armstrong0/PDP8e/README

Autostart is now implemented.  If the sw switch is asserted and then the unit is powered up, the boot code for OS8 is deposited into memory and executed.  Note there is a small delay while the code waits for the sd card to be ready. 

Now booting OS8 from SD Card!!

Timing information removed from parameters.v and now in timing.v   A module in the same directory as the top level (for the particular FPGA) generates timing debounce constants for the serial port and the spi port of the sd card interface.  As well it generates start up delays for the sd card and the delays for the front panel.

This PDP8e (ice40hx8k) can now have 10 k words of memory.  The only caviot is that to pass Adder and Extended Memory diagnostics you must recompile to 8 k.

There has been a major state machine revision where most of the exceptional processing is handle in F0 istead of various states (F3, E3, D3, H0).  Easier to make sure I have all of the conditions covered.

All tests now pass.  The ma and pc units have been merged.  All source files have been linted and formatted.  Lint does not like the bit ordering in the PDP8's registers but I kept it. 

The design passes all three EAE tests, so a complete EAE implementation.  

//There is a problem with the serial port, if the halt switch is set, it is 
//possible that the serial transmitter was in the middle of a character, 
//leaving the line is the spacing state, this messes up the receiving uart.
This is NOT a problem!  Halt does not stop the TX state machine from running.  Iwill complete the sending of the charactor.  The main state machine will stop in the F0 state and nothing more will happen!

The front panel code has been modified so that: when in halt state and a control switch is toggled the run LED comes on for the debounce time.  

The Least Significant Bit (bit 11) of the state display has been reallocated to the EAE state, LED on signifies the "B" mode.

Bit 9 of the state display indicates if the disk (sd card) is ready.

Toggling the "sw" switch up and pressing address load result in octal 7777 being loaded into the memory address register, useful when starting the binary loader - which is loaded in memory during FPGA boot.  It is necessary to have switch 0 up (high) for the bootloader to use the console port.

The top level Makefile can be used to clean the subdirectories. Some of the sub directory makefiles have been modified to allow a target of vdent.  This formats the code in that subdirectory.

Hardware is an ICE40HX8K device on an ICEWERKS module bought from robot shop.

Front panel has a self designed graphic... Code to design it is in another
repository.  Also in that repository is a set of tools to determine the wiring
required.  Wiring was mostly done with 30 AWG wirewrap wire.  Switches however
were wired with 22 AWG copper bus wire.  

Almost all of the circuitry is on the Icewerks modules.  Exceptions are the
LED's and associated current limiting resistors, toggle switches, rotary
display select switch and a USB to TTL serial module.  Two 33 ufd caps were,
placed between 3.3 volt and ground on the switch buses.  3 30 AWG wires were
used to connect the ICEWERKS module ground to the switch ground.  Only 1 30
AWG wire is used to hook up 3.3 Volts.

Yellow LED's required - address 15, data display 12, run 1 and display selected
indicator 6.  Total 34.  Current limit resistor value is: 220 ohms.

The rotary switch has been replaced with a push button switch.  When the rotary switch was used, all of the 6 lines assigned to this function were inputs to the FPGA and the LEDS were driven from the switch. Now one input is used by the push button switch.  The other 5 lines are now outputs driving the LEDS.  LED's are grouped into two groups three.  The cathodes of the three LEDS are tied together and through a 220 ohm resistor go to an FPGA pin.  Same for the other group of three.  Then corresponding anodes of LED's are tied together and are driven by an FPGA pin.  To turn a LED on the cathode of the LED is driven low, either (01 or 10) and the anode is driven high (100, 010, or 001).   

This repository contains the Verilog code for the FPGA and test code to verify
code correctness.  

The design is partitioned into pieces, each piece has its own directory.  In
some directories test code exists to test that module.  

The tools required to build this code are a verilog compiler, a verilog
simulator, a couple of PDP8 tools palbart and macro8x.  The palbart version
required is: pal-2.13, 03 May 2015.

The FPGA tools used are Icestorm tools set, yosys and nextnpr.  Iverilog was
used as a simulator and Verilator was used as a linting tool.

The directory "integrate" contains a test bed that will run selected DEC PDP8e
diagnostics, this was used to debug and verify the design.  This directory also contains a script that leads one though loading a diagnostic program onto hardware and then running the test.

The FPGA that was targeted is a Lattice Semiconductor ICE40Hx8k.  Very little
code is targeted at that FPGA, that is the code that sets up the internal pll
: pll.v the remaining (and vast majority ) code is generic.  A hardware wait state has been added so that memory reads take 2 states, I think this is necessary because the 8k x 12 memory is made of 4 kilobit block ram.  This necessitates lots of levels of logic after the memories in order to select the correct memory.  

The directory FPGA_IO_test contains code useful in testing out wiring.
Entering the directory and typing make should build an FPGA image that can be
burned into the ICEWERKS module using the command "make burn".

To build the FPGA, enter the directory FPGA_image and type make.  If make is
successful, then the image can be burned into the flash device on the ICEWERKS
module using: make burn.
