armstrong0/PDP8e/ma/ma.v

`ifdef up5k
`include "../spram/up_spram.v"
`else
`include "../ram/ram.v"
`endif

module ma (
    input clk,
    input reset,
    input [0:11] ac,
    input [0:11] mq,
    input [0:11] sr,
    input sw,
    input [4:0] state,
    input addr_loadd,
    depd,
    examd,
    extd_addrd,
    input int_in_prog,
    input [0:2] IF,
    DF,
    input skip,
    input eskip,
`ifdef RK8E
    input [0:14] dmaAddr,
    input [0:11] disk2mem,
    input to_disk,
    input data_break,
    output reg [0:11] mem2disk,
`endif
    output reg index,
    output reg [0:11] instruction,
    output reg [0:11] mdout,
    output reg [0:14] eaddr  // drives the panel LEDs
);

  reg [0:4] current_page;
  reg [0:11] mdin, idx_tmp, pc, next_pc, skip_pc;
  reg write_en;
  wire [0:11] mdtmp;
  `include "../parameters.v"


`ifdef up5k
  up_spram ram (
      .wdata({4'b0, mdin}),
      .addr(eaddr),
      .wr(write_en),
      .clk(clk),
      .rdata(mdtmp)
  );
`else
  ram ram (
      .din(mdin),
      .addr(eaddr),
      .write_en(write_en),
      .clk(clk),
      .dout(mdtmp)
  );
`endif




  always @(posedge clk) begin
    if (reset) begin
      eaddr <= 15'o00000;
      instruction <= 12'o7000;
      current_page <= 0;
      write_en <= 0;
      index <= 1'b0;
`ifdef RK8E      
      mem2disk <= 12'o0;
`endif     
      idx_tmp <= 12'o0;
      mdin <= 12'o0;
    end else begin
      write_en <= 0;
      eaddr[3:14] <= eaddr[3:14];
      mdin <= mdin;
      case (state)
        F0: begin
          pc <= eaddr[3:14];
`ifdef RK8E	  
	  if (data_break == 1) begin
		  mdin <= disk2mem;
          eaddr <= dmaAddr;
          pc <= eaddr[3:14];
          end
`else          
          pc <= eaddr[3:14];
`endif
          mdout <= mdtmp;  // catches the case where we are spinning in F0
        end
        FW: begin
          mdout <= mdtmp;
          instruction <= mdtmp;
          eaddr[3:14] <= pc + 12'o0001;  // set up for fetch of immediate
          // operand or address for EAE operations
        end
        F1: ;
        F2: begin
          current_page <= pc[0:4];
          mdout <= mdtmp;
          skip_pc <= pc + 12'o0002;
          next_pc <= pc + 12'o0001;

        end
`ifdef EAE        
        F2A: begin
          casez (instruction)
            12'b1111??0?0011,  // 7403 SCL
            12'b1111??0?0101,  // 7405 MUY
            12'b1111??0?0111,  // 7407 DIV
            12'b1111??0?1011,  // 7413 SHL
            12'b1111??0?1101,  // 7415 ASR
            12'b1111??0?1111,  // 7417 LSR
            12'b1111??1?0101,  // SCA - MUL
            12'b1111??1?0111,  // SCA - DIV
            12'b1111?1111011,  // SCA - SHL
            12'b1111?1111101,  // SCA - ASR
            12'b1111??1?1111,  // SCA - LSR
            12'b1111??1?0011:  // SCA - SCL
            next_pc <= pc + 12'o2;  // skip the operand
            default next_pc <= pc + 12'o1;
          endcase
          mdout <= mdtmp;
        end
        F2B: begin
          casez (instruction)
            12'b1111??0?1011,  // 7413 SHL
            12'b1111??0?1101,  // 7415 ASR
            12'b1111??0?1111,  // 7417 LSR
            12'b1111??0?0101,  // 7405 MUY
            12'b1111??0?0111,  // 7407 DIV
            12'b1111??1?0011,  // DAD - DLD 7443 CAMDAD
            12'b1111??1?0101:  // DST 7445
          begin
              // eaddr has the address of the operand,
              // the memory cycle will be finished by the defer cycle
              next_pc <= pc + 12'o2;  // skip the operand
            end
            default: begin
              next_pc <= pc + 12'o1;
              skip_pc <= pc + 12'o2;
            end
          endcase
          mdout <= mdtmp;
        end
`endif        
        F3: begin
          casez (instruction[0:4])
            5'b0???0: eaddr <= {IF, 5'b0, instruction[5:11]};
            5'b0???1: eaddr <= {IF, current_page, instruction[5:11]};
            5'b100?0:  // JMS page 0
            eaddr <= {IF, 5'b0, instruction[5:11]};
            5'b100?1:  // JMS current page
            eaddr <= {IF, current_page, instruction[5:11]};
            5'b101?0: // JMP page 0
            begin
              eaddr   <= {IF, 5'b0, instruction[5:11]};
              next_pc <= {5'b0, instruction[5:11]};
            end
            5'b101?1: // JMP current page
            begin
              eaddr   <= {IF, current_page, instruction[5:11]};
              next_pc <= {current_page, instruction[5:11]};
            end
            5'b11???:  // 6 and 7 OPR and IOT
            if ((skip == 1) || (eskip == 1)) begin
              eaddr   <= {IF, skip_pc};
              next_pc <= skip_pc;
            end else eaddr <= {IF, next_pc};
          endcase
        end
        D0: if (eaddr[3:11] == 9'o001) index <= 1'b1;
 else index <= 1'b0;
        DW: begin
          mdout <= mdtmp;
        end
        D1: begin
          if (index == 1'b1) begin
            mdin <= mdout + 12'o0001;
            idx_tmp <= mdout + 12'o0001;
            write_en <= 1;
          end else eaddr[3:14] <= mdout;
        end
        D2: ;
        D3: begin
          if (index == 0) eaddr[3:14] <= mdout;
          else begin
            eaddr[3:14] <= idx_tmp;
            index <= 0;
          end
          ;
          casez (instruction[0:2])
            AND, TAD, ISZ, DCA, OPR: eaddr[0:2] <= DF;
            JMP: begin
              if (index) next_pc <= idx_tmp;  // both use IF which is set in F0
              else next_pc <= mdout;  // right address, ready for 
              // interrupt processing
              eaddr[0:2] <= IF;
            end

            JMS: ;
            IOT: ;  // should never get here
            default: ;
          endcase
        end
        E0: begin
`ifdef EAE        
          if ((instruction & 12'b111100101111) == DST) begin
            mdin <= mq;
            write_en <= 1'b1;
          end
`endif          
        end
        EW: begin
          if (int_in_prog == 1) begin
            instruction <= 12'o4000;
            eaddr <= 15'o0000;
            mdin <= next_pc;
          end else
            case (instruction[0:2])
              ISZ, AND, TAD: ;
              JMS: begin
                   mdin <= next_pc;
                   eaddr[0:2] <= IF; // handles JMS across fields
                   end
              DCA: mdin <= ac;
              OPR: begin
                eaddr[3:14] <= eaddr[3:14] + 12'd1;
                mdin <= ac;
                mdout <= mdtmp;
              end
              default: ;
            endcase
          mdout <= mdtmp;
        end
        E1:
        case (instruction[0:2])
          ISZ: begin
            mdin <= mdout + 12'o0001;
            write_en <= 1;
            if (mdout == 12'o7777) next_pc <= skip_pc;
          end
          JMS: begin
            write_en <= 1;
            mdin <= next_pc;
          end
          DCA: begin
            mdin <= ac;
            write_en <= 1;
          end
          OPR: begin
`ifdef EAE          
            if ((instruction & 12'b111100101111) == DST) begin
              mdin <= ac;
              write_en <= 1'b1;
            end
`endif            
          end
          default: ;
        endcase
        E2: begin
          case (instruction[0:2])
            ISZ: ;
            DCA: mdin <= ac;
            JMS:
            if (int_in_prog) begin
              eaddr   <= 15'o0001;
              next_pc <= 12'o0001;
            end else next_pc <= eaddr[3:14] + 12'd1;
            OPR: ;
          endcase
          mdout <= mdtmp;
        end
        E3: begin
          // on interrupt we go to IF 0 set up in E2 above
          if (int_in_prog == 1) eaddr <= {3'b000, next_pc};
          else eaddr <= {IF, next_pc};
        end
        //H0: ;
        HW: mdout <= mdtmp;
        H1:
        if (addr_loadd == 1'b1)
          if (sw == 1'b1) eaddr[3:14] <= 12'o7777;
          else eaddr[3:14] <= sr;
        else if (depd == 1'b1) begin
          mdin <= sr;
          write_en <= 1;
        end 
        else if (extd_addrd == 1'b1) begin
          eaddr[0:2] <= sr[6:8];
        end  
        H2: if ((depd == 1'b1) | (examd == 1'b1)) eaddr[3:14] <= eaddr[3:14] + 12'o0001;
        H3: ;
`ifdef RK8E
        DB0:;
        DB1: begin
          mdin <= disk2mem;
          if (to_disk == 0) begin 
	       write_en <= 1'b1;
          end
        end
        DB2: begin
          if (to_disk == 1'b1) begin
            mem2disk <= mdtmp;
          end
          eaddr[0:14] <= {IF,pc};
        end
`endif

        default: ;
      endcase
    end
  end
endmodule
