armstrong0/PDP8e/sd_debug/palbart.c

/******************************************************************************/
/*                                                                            */
/* Program:  PAL (BART version)                                               */
/* File:     pal.c                                                            */
/* Author:   Gary A. Messenbrink                                              */
/*           gam@rahul.net                                                    */
/*                                                                            */
/* Purpose:  A 2 pass PDP-8 pal-like assembler.                               */
/*                                                                            */
/* PAL(1)                                                                     */
/*                                                                            */
/* NAME                                                                       */
/*    pal - a PDP/8 pal-like assembler.                                       */
/*                                                                            */
/* SYNOPSIS:                                                                  */
/*    pal [ -$ -d -h -e -l -p -r -t -v -x ] inputfile                         */
/*                                                                            */
/* DESCRIPTION                                                                */
/*    This is a cross-assembler to for PDP/8 assembly language programs.      */
/*    It will produce an output file in bin format, rim format, and using the */
/*    appropriate pseudo-ops, a combination of rim and bin formats.           */
/*    A listing file is always produced and with an optional symbol table     */
/*    and/or a symbol cross-reference (concordance).  The permanent symbol    */
/*    table can be output in a form that may be read back in so a customized  */
/*    permanent symbol table can be produced.  Any detected errors are output */
/*    to a separate file giving the filename in which they were detected      */
/*    along with the line number, column number and error message as well as  */
/*    marking the error in the listing file.                                  */
/*    The following file name extensions are used:                            */
/*       .pal    source code (input)                                          */
/*       .lst    assembly listing (output)                                    */
/*       .bin    assembly output in DEC's bin format (output)                 */
/*       .rim    assembly output in DEC's rim format (output)                 */
/*       .err    assembly errors detected (if any) (output)                   */
/*       .prm    permanent symbol table in form suitable for reading after    */
/*               the EXPUNGE pseudo-op.                                       */
/*                                                                            */
/* OPTIONS                                                                    */
/*    -$   Allow files to not end with $                                      */
/*    -d   Dump the symbol table at end of assembly                           */
/*    -h   Show help                                                          */
/*    -e   Don't allow generation of links                                    */
/*    -l   Allow generation of links (default is link generation)             */
/*    -n   No redefinition of permanent symbols with labels                   */
/*    -p   Generate a file with the permanent symbols in it.                  */
/*         (To get the current symbol table, assemble a file than has only    */
/*          a $ in it.)                                                       */
/*    -r   Produce output in rim format (default is bin format)               */
/*    -tN  Set tab stops to N spaces (default is 8)                           */
/*    -v   Display program version.                                           */
/*    -x   Generate a cross-reference (concordance) of user symbols.          */
/*    -b   Allow bad practice code that PAL8 doesn't generate errors for      */
/*                                                                            */
/* DIAGNOSTICS                                                                */
/*    Assembler error diagnostics are output to an error file and inserted    */
/*    in the listing file.  Each line in the error file has the form          */
/*                                                                            */
/*       <filename>(<line>:<col>) : error:  <message> at Loc = <loc>          */
/*                                                                            */
/*    An example error message is:                                            */
/*                                                                            */
/*       bintst.pal(17:9) : error:  undefined symbol "UNDEF" at Loc = 07616   */
/*                                                                            */
/*    The error diagnostics put in the listing start with a two character     */
/*    error code (if appropriate) and a short message.  A carat '^' is        */
/*    placed under the item in error if appropriate.                          */
/*    An example error message is:                                            */
/*                                                                            */
/*          17 07616 3000          DCA     UNDEF                              */
/*       UD undefined                      ^                                  */
/*          18 07617 1777          TAD  I  DUMMY                              */
/*                                                                            */
/*    When an indirect is generated, an at character '@' is placed after the  */
/*    the instruction value in the listing as an indicator as follows:        */
/*                                                                            */
/*          14 03716 1777@         TAD     OFFPAG                             */
/*                                                                            */
/*    Undefined symbols are marked in the symbol table listing by prepending  */
/*    a '?' to the symbol.  Redefined symbols are marked in the symbol table  */
/*    listing by prepending a '#' to the symbol.  Examples are:               */
/*                                                                            */
/*       #REDEF   04567                                                       */
/*        SWITCH  07612                                                       */
/*       ?UNDEF   00000                                                       */
/*                                                                            */
/*    Refer to the code for the diagnostic messages generated.                */
/*                                                                            */
/* BUGS                                                                       */
/*    This program will accept source that real PAL will not. To ensure       */
/*    valid source assemble on real or simulated PDP-8.                       */
/*    Different PAL versions have different permanent symbols defined. This   */
/*    program define more than and PAL version. By default redefining them    */
/*    as a label is not an error. It is for normal PAL. The -n flag will      */
/*    make redefining an error.                                               */
/*                                                                            */
/*    Only a minimal effort has been made to keep the listing format          */
/*    anything like the PAL-8 listing format.                                 */
/*    The operation of the conditional assembly pseudo-ops may not function   */
/*    exactly as the DEC versions.  I did not have any examples of these so   */
/*    the implementation is my interpretation of how they should work.        */
/*                                                                            */
/*    The RIMPUNch and BINPUNch pseudo-ops do not change the binary output    */
/*    file type that was specified on startup.  This was intentional and      */
/*    and allows rim formatted data to be output prior to the actual binary   */
/*    formatted data.  On UN*X style systems, the same effect can be achieved */
/*    by using the "cat" command, but on DOS/Windows systems, doing this was  */
/*    a major chore.                                                          */
/*                                                                            */
/*    The floating point input does not generate values exactly as the DEC    */
/*    compiler does.  I worked out several examples by hand and believe that  */
/*    this implementation is slightly more accurate.  If I am mistaken,       */
/*    let me know and, if possible, a better method of generating the values. */
/*                                                                            */
/*    CDF .-.                                                                 */
/*       Generates 2201 when assembled at 5000. This looks like a bug in OS/8 */
/*       PAL                                                                  */
/*                                                                            */
/* BUILD and INSTALLATION                                                     */
/*    The current version has only been built under Linux.                    */
/*    Earlier versions have been built and successfully executed on:          */
/*      a.  Linux (80486 CPU)using gcc                                        */
/*      b.  RS/6000 (AIX 3.2.5)                                               */
/*      c.  Borland C++ version 3.1  (large memory model)                     */
/*      d.  Borland C++ version 4.52 (large memory model)                     */
/*    with no modifications to the source code.                               */
/*                                                                            */
/*    On UNIX type systems, store the the program as the pal command          */
/*    and on PC type systems, store it as pal.exe                             */
/*                                                                            */
/* HISTORICAL NOTE:                                                           */
/*    This assembler was written to support the fleet of PDP-8 systems        */
/*    used by the Bay Area Rapid Transit System.  As of early 1997,           */
/*    this includes about 40 PDP-8/E systems driving the train destination    */
/*    signs in passenger stations.                                            */
/*                                                                            */
/* REFERENCES:                                                                */
/*    This assembler is based on the pal assembler by:                         */
/*       Douglas Jones <jones@cs.uiowa.edu> and                               */
/*       Rich Coon <coon@convexw.convex.com>                                  */
/*                                                                            */
/* DISCLAIMER:                                                                */
/*    See the symbol table for the set of pseudo-ops supported.               */
/*    See the code for pseudo-ops that are not standard for PDP/8 assembly.   */
/*    Refer to DEC's "Programming Languages (for the PDP/8)" for complete     */
/*    documentation of pseudo-ops.                                            */
/*    Refer to DEC's "Introduction to Programming (for the PDP/8)" or a       */
/*    lower level introduction to the assembly language.                      */
/*                                                                            */
/* WARRANTY:                                                                  */
/*    If you don't like it the way it works or if it doesn't work, that's     */
/*    tough.  You're welcome to fix it yourself.  That's what you get for     */
/*    using free software.                                                    */
/*                                                                            */
/* COPYRIGHT NOTICE:                                                          */
/*    This is free software.  There is no fee for using it.  You may make     */
/*    any changes that you wish and also give it away.  If you can make       */
/*    a commercial product out of it, fine, but do not put any limits on      */
/*    the purchaser's right to do the same.  If you improve it or fix any     */
/*    bugs, it would be nice if you told me and offered me a copy of the      */
/*    new version.                                                            */
/*                                                                            */
/*                                                                            */
/* Amendments Record:                                                         */
/*  Version  Date    by   Comments                                            */
/*  ------- -------  ---  --------------------------------------------------- */
/*    v1.0  12Apr96  GAM  Original                                            */
/*    v1.1  18Nov96  GAM  Permanent symbol table initialization error.        */
/*    v1.2  20Nov96  GAM  Added BINPUNch and RIMPUNch pseudo-operators.       */
/*    v1.3  24Nov96  GAM  Added DUBL pseudo-op (24 bit integer constants).    */
/*    v1.4  29Nov96  GAM  Fixed bug in checksum generation.                   */
/*    v2.1  08Dec96  GAM  Added concordance processing (cross reference).     */
/*    v2.2  10Dec96  GAM  Added FLTG psuedo-op (floating point constants).    */
/*    v2.3   2Feb97  GAM  Fixed paging problem in cross reference output.     */
/* DJG: I started with the 2.5 RK version but found when looking on the net   */
/* later that multiple diverging version existed. I have tried to combine     */
/* the fixed into one version. I took the version info below from the versions*/
/* I pulled from.                                                             */
/* http://dustyoldcomputers.com/pdp-common/reference/host/index.html          */
/* http://www.dunnington.u-net.com/public/PDP-8/palbart.c                     */
/* http://sourcecodebrowser.com/palbart/2.4/palbart-2_84_8c_source.html       */
/* http://packages.qa.debian.org/p/palbart.html                               */
/*    v2.4  11Apr97  GAM  Fixed problem with some labels being put in cross   */
/*                        reference multiple times.                           */
/*                        Started with RK version, Attempted to merge         */
/*                        GAM V2.4 and PNT change DJG                         */
/*    v2.4  29Oct07  RK   Added 4 character tabstop; IOTs for TA8/E.          */
/*    v2.4  19Jan03  PNT  Added ASCII pseudo-op, like TEXT but not packed.    */
/*    v2.5  03Nov07  RK   Fixed buffer overflow problem in readLine and       */
/*                        increased symbol table size                         */
/*    v2.6  14Jul03  PNT  Added missing TTY symbols, and "1st TTY" symbols.   */
/*    v2.7  14Jun13  DJG  David Gesswein djg@pdp8online.com                   */
/*                        Merged other changes found online giving duplicate  */
/*                         Versions in the history                            */
/*                         Didn't copy over deleting -l literal flag          */
/*                        All fixes to make it match OS/8 PAL8 better         */
/*                        Fixed handling of IFDEF type conditionals           */
/*                        Fixed excessive redefined symbol errors             */
/*                         PAL8 uses 12 bit symbols and this program label    */
/*                         symbols are 15 bit.                                */
/*                        Added FILENAME and DEVNAME psuedo ops               */
/*                        Added OPR and KCF instructions. Fixed RMF           */
/*                        Allowed space after =                               */
/*                        Prevented I and D from being deleted by EXPUNGE     */
/*                        Allowed permanent symbols to be redefined with error*/
/*                         PAL8 updates without message. Error is just warning*/
/*                        Fixed certain cases of memory reference generation  */
/*                        Allowed unary +                                     */
/*                        Fixed " character literal at end of line            */
/*                        Fixed errors in reloc handling                      */
/*                        Fixed [CDF CIF type expressions                     */
/*                        Made title default to first line                    */
/*                        Fixed checksum when nopunch used                    */
/*                        Fixed FIXTAB                                        */
/*                        Probably added more subtle bugs                     */
/*    v2.8  15Jun13  DJG  Merged versions found on net. See above             */
/*                        Added * to RELOC addresses in listing               */
/*                        Changed default to literal/links on. Added -e to    */
/*                         turn off                                           */
/*                        Fixed PAGE when RELOC used                          */
/*                        Changed SPF to TFL and SPI to TSK                   */
/*                        Make error when changing permanent symbol to label  */
/*                         if -e flag is used                                 */
/*                        Allow space oring in IFZERO etc                     */
/*                        Fixed handling of page zero overflow                */
/*    v2.9  23Jun13  DJG  Fixed properly all pages literal handling           */
/*                         changing page doesn't cause loss of last literal   */
/*                         location used.                                     */
/*                        Fixed bin generation if no origin set               */
/*    v2.9a 01Jul13  DJG  Fixed Comment. Binaries not updated                 */
/*    v2.10 08Feb14  DJG  Changed trailer to 8 bytes since pip didn't like    */
/*                        trailer of one 0x80                                 */
/*    v2.11 19Apr15  DPI  Fixed incorrect link generation with impled 0200    */
/*                        starting address. Patch from Doug Ingrams           */
/*    v2.12 28Apr15  DJG  Fixed incorrect handling of reloc, expressions with */
/*                        undefined symbols. Fixed conditional assembly with  */
/*                        undefined symbols. Added new flag to allow file to  */
/*                        not end with $                                      */
/*    v2.13 02May15  DPI  Fixed bug in readLine when removing \r from a blank */
/*                        line.  Changed -s to -$ in -h display.  Corrected   */
/*                        version comment.                                    */
/*    v2.13 03May15  DJG  Moved TITLE, BANK to new additional option.         */
/*    v2.14 07Mar23  DJG  Fixed compile warning about possible buffer overrun.*/
/*    v2.15 31Oct23  FPW  Fixed FLTG, patch from Folke Will.                  */
/*                        FLTG is palbart extension from MACRO-8              */
/*          02Jan24  DJG  Added -b to allow code PAL8 accepts but bad practice*/
/*    v2.16 28May24  DBA  Added RK8E instructions                             */
/*    v2.17 25Jum25  DBA  Corrected RK8E instructions                             */
/* Change release variable below when you update. Send changes back to        */
/*   David Gesswein, djg@pdp8online.com.                                      */
/******************************************************************************/

#include <ctype.h>
#include <stdio.h>
#include <stdlib.h>
#include <string.h>
#include <errno.h>

char *release = "pal-2.17, 25 June 2025";

/* Set to 1 and use -e flag to make ( and [ literals errors */
#define LITERAL_ERROR        0

#define LINELEN              132
#define LIST_LINES_PER_PAGE  55         /* Includes 5 line page header.       */
#define NAMELEN             128
#define SYMBOL_COLUMNS        5
#define SYMLEN                7
#define SYMBOL_TABLE_SIZE  4096
#define TITLELEN             63
#define XREF_COLUMNS          8

#define ADDRESS_FIELD  00177
#define FIELD_FIELD   070000
#define INDIRECT_BIT   00400
#define LAST_PAGE_LOC  00177
#define OP_CODE        07000
#define PAGE_BIT       00200

#ifdef  PAGE_SIZE
#undef  PAGE_SIZE
#endif
#define PAGE_SIZE      00200

#define PAGE_FIELD     07600
#define PAGE_ZERO_END  00200

/* Macro to get the number of elements in an array.                           */
#define DIM(a) (sizeof(a)/sizeof(a[0]))

/* Macro to get the address plus one of the end of an array.                  */
#define BEYOND(a) ((a) + DIM(A))

#define is_blank(c) ((c==' ') || (c=='\t') || (c=='\f') || (c=='>'))
#define isend(c)   ((c=='\0')|| (c=='\n'))
#define isdone(c)  ((c=='/') || (isend(c)) || (c==';'))

/* Macros for testing symbol attributes.  Each macro evaluates to non-zero    */
/* (true) if the stated condition is met.                                      */
/* Use these to test attributes.  The proper bits are extracted and then      */
/* tested.                                                                    */
#define M_CONDITIONAL(s) ((s & CONDITION) == CONDITION)
#define M_DEFINED(s)     ((s & DEFINED) == DEFINED)
#define M_DUPLICATE(s)   ((s & DUPLICATE) == DUPLICATE)
#define M_FIXED(s)       ((s & FIXED) == FIXED)
#define M_LABEL(s)       ((s & LABEL) == LABEL)
#define M_MRI(s)         ((s & MRI) == MRI)
#define M_MRIFIX(s)      ((s & MRIFIX) == MRIFIX)
#define M_PSEUDO(s)      ((s & PSEUDO) == PSEUDO)
#define M_REDEFINED(s)   ((s & REDEFINED) == REDEFINED)
#define M_UNDEFINED(s)   (!M_DEFINED(s))
#define M_PERM_REDEFINED(s)   ((s & PERM_REDEFINED) == PERM_REDEFINED)

/* This macro is used to test symbols by the conditional assembly pseudo-ops. */
#define M_DEF(s) (M_DEFINED(s))
#define M_COND(s) (M_CONDITIONAL(s))
#define M_DEFINED_CONDITIONALLY(t) (M_DEF(t) && ((pass==1) ||!M_COND(t)))

typedef unsigned char BOOL;
typedef unsigned char BYTE;
typedef short    int  WORD16;
typedef long     int  WORD32;

#ifndef FALSE
  #define FALSE 0
  #define TRUE (!FALSE)
#endif

/* Line listing styles.  Used to control listing of lines.                    */
enum linestyle_t
{
  LINE, LINE_VAL, LINE_LOC_VAL, LOC_VAL
};
typedef enum linestyle_t LINESTYLE_T;

/* Symbol Types.                                                              */  
/* Note that the names that have FIX as the suffix contain the FIXED bit      */
/* included in the value.                                                     */
/*                                                                            */
/* The CONDITION bit is used when processing the conditional assembly PSEUDO- */
/* OPs (e.g., IFDEF).  During pass 1 of the assembly, the symbol is either    */
/* defined or undefined.  The condition bit is set when the symbol is defined */
/* during pass 1 and reset on pass 2 at the location the symbol was defined   */
/* during pass 1.  When processing conditionals during pass 2, if the symbol  */
/* is defined and the condition bit is set, the symbol is treated as if it    */
/* were undefined.  This gives consistent behavior of the conditional         */
/* pseudo-ops during both pass 1 and pass 2.                                  */
enum symtyp
{
  UNDEFINED = 0000,
  DEFINED   = 0001,
  FIXED     = 0002,
  MRI       = 0004    | DEFINED,
  LABEL     = 0010    | DEFINED,
  REDEFINED = 0020    | DEFINED,
  DUPLICATE = 0040    | DEFINED,
  PSEUDO    = 0100    | FIXED | DEFINED,
  CONDITION = 0200    | DEFINED,
  PERM_REDEFINED = 0400,
  MRIFIX    = MRI     | FIXED | DEFINED,
  DEFFIX    = DEFINED | FIXED
};
typedef enum symtyp SYMTYP;

enum pseudo_t
{
  BANK,    BINPUNCH, DECIMAL, DUBL,    EJECT,    ENPUNCH, EXPUNGE, FIELD,
  FIXMRI,  FIXTAB,   FLTG,    IFDEF,   IFNDEF,   IFNZERO, IFZERO,  NOPUNCH,
  OCTAL,   PAGE,     PAUSE,   RELOC,   RIMPUNCH, SEGMNT,  TEXT,    TITLE,
  XLIST,   ZBLOCK, FILENAME, DEVICE, ASCII
};
typedef enum pseudo_t PSEUDO_T;

struct sym_t
{
  SYMTYP  type;
  char    name[SYMLEN];
  WORD16  val;
  int     xref_index;
  int     xref_count;
};
typedef struct sym_t SYM_T;

struct lpool_t
{
  WORD16  loc;
  WORD16  last_punched;
  WORD16  pool[PAGE_SIZE];
};
typedef struct lpool_t LPOOL_T;

struct emsg_t
{
  char  *list;
  char  *file;
};
typedef struct emsg_t EMSG_T;

struct errsave_t
{
  char  *mesg;
  int    col;
};
typedef struct errsave_t ERRSAVE_T;

struct fltg_
{
  WORD16 exponent;
  WORD32 mantissa;
};
typedef struct fltg_ FLTG_T;

/*----------------------------------------------------------------------------*/

/* Function Prototypes                                                        */

int     binarySearch( char *name, int start, int symbol_count );
int     compareSymbols( const void *a, const void *b );
void    conditionFalse( void );
void    conditionTrue( void );
SYM_T  *defineLexeme( int start, int term, WORD16 val, SYMTYP type );
SYM_T  *defineSymbol( char *name, WORD16 val, SYMTYP type, WORD16 start);
void    endOfBinary( void );
void    errorLexeme( EMSG_T *mesg, int col );
void    errorMessage( EMSG_T *mesg, int col );
void    errorSymbol( EMSG_T *mesg, char *name, int col );
SYM_T  *eval( void );
WORD32  evalDubl( WORD32 initial_value );
FLTG_T *evalFltg( void );
SYM_T  *evalSymbol( void );
void    getArgs( int argc, char *argv[] );
WORD32  getDublExpr( void );
WORD32  getDublExprs( void );
FLTG_T *getFltgExpr( void );
FLTG_T *getFltgExprs( void );
SYM_T  *getExpr( void );
WORD16  getExprs( void );
WORD16  incrementClc( void );
void    inputDubl( void );
void    inputFltg( void );
WORD16  insertLiteral( LPOOL_T *pool, WORD16 value, int fieldpage_index );
char   *lexemeToName( char *name, int from, int term );
void    listLine( void );
SYM_T  *lookup( char *name );
void    moveToEndOfLine( void );
void    nextLexBlank( void );
void    nextLexeme( void );
void    normalizeFltg( FLTG_T *fltg );
void    onePass( void );
void    printCrossReference( void );
void    printErrorMessages( void );
void    printLine(char *line, WORD16 loc, WORD16 val, LINESTYLE_T linestyle);
void    printPageBreak( void );
void    printPermanentSymbolTable( void );
void    printSymbolTable( void );
BOOL    pseudoOperators( PSEUDO_T val );
void    punchChecksum( void );
void    punchLocObject( WORD16 loc, WORD16 val );
void    punchLiteralPool( LPOOL_T *p, BOOL punch_page0 );
void    punchOutObject( WORD16 loc, WORD16 val );
void    punchLeader( int count );
void    punchObject( WORD16 val );
void    punchOrigin( WORD16 loc );
void    readLine( void );
void    saveError( char *mesg, int cc );
BOOL    testForLiteralCollision( WORD16 loc );
void    topOfForm( char *title, char *sub_title );

/*----------------------------------------------------------------------------*/

/* Table of pseudo-ops (directives) which are used to setup the symbol        */
/* table on startup and when the EXPUNGE pseudo-op is executed.               */
SYM_T pseudo[] =
{
  { PSEUDO, "ASCII",  ASCII   },    /* Put 8-bit ASCII into memory (see TEXT) */
  { PSEUDO, "BINPUN", BINPUNCH },   /* Output in Binary Loader format.        */
  { PSEUDO, "DECIMA", DECIMAL },    /* Read literal constants in base 10.     */
  { PSEUDO, "DEVICE", DEVICE },     /* Pack 6 bit device name into memory     */
  { PSEUDO, "DUBL",   DUBL    },    /* Ignored (unsupported).                 */
  { PSEUDO, "EJECT",  EJECT   },    /* Eject a page in the listing.           */
  { PSEUDO, "ENPUNC", ENPUNCH },    /* Turn on object code generation.        */
  { PSEUDO, "EXPUNG", EXPUNGE },    /* Remove all symbols from symbol table.  */
  { PSEUDO, "FIELD",  FIELD   },    /* Set origin to memory field.            */
  { PSEUDO, "FILENA", FILENAME },   /* Pack 6 bit filename into memory.       */
  { PSEUDO, "FIXMRI", FIXMRI  },    /* Like =, but creates mem ref instruction*/
  { PSEUDO, "FIXTAB", FIXTAB  },    /* Mark current symbols as permanent.     */
  { PSEUDO, "FLTG",   FLTG    },    /* Ignored (unsupported).                 */
  { PSEUDO, "IFDEF",  IFDEF   },    /* Assemble if symbol is defined.         */
  { PSEUDO, "IFNDEF", IFNDEF  },    /* Assemble if symbol is not defined.     */
  { PSEUDO, "IFNZER", IFNZERO },    /* Assemble if symbol value is not 0.     */
  { PSEUDO, "IFNZRO", IFNZERO },    /* Assemble if symbol value is not 0.     */
  { PSEUDO, "IFZERO", IFZERO  },    /* Assemble if symbol value is 0.         */
  { PSEUDO, "NOPUNC", NOPUNCH },    /* Turn off object code generation.       */
  { PSEUDO, "OCTAL",  OCTAL   },    /* Read literal constants in base 8.      */
  { PSEUDO, "PAGE",   PAGE    },    /* Set orign to page +1 or page n (0..37).*/
  { PSEUDO, "PAUSE",  PAUSE   },    /* Ignored                                */
  { PSEUDO, "RELOC",  RELOC   },    /* Assemble to run at a different address.*/
  { PSEUDO, "RIMPUN", RIMPUNCH },   /* Output in Read In Mode format.         */
  { PSEUDO, "SEGMNT", SEGMNT  },    /* Like page, but with page size=1K words.*/
  { PSEUDO, "TEXT",   TEXT    },    /* Pack 6 bit trimmed ASCII into memory.  */
  { PSEUDO, "XLIST",  XLIST   },    /* Toggle listing generation.             */
  { PSEUDO, "ZBLOCK", ZBLOCK  },    /* Zero a block of memory.                */
  { PSEUDO, "TITLE",  TITLE   },    /* Use the text string as a listing title.*/
  { PSEUDO, "BANK",   BANK    }     /* Like field, select some 32K out of 128K*/
};
/* Number o extended pseudo operators to ignore unless command option specified
 * to enable */
#define NUMBER_ADDITIONAL_PSEUDO 2

/* Symbol Table                                                               */
/* The table is put in lexical order on startup, so symbols can be            */
/* inserted as desired into the initial table.                                */
/* really_permanent_symbols aren't removed by EXPUNGE                         */
SYM_T really_permanent_symbols[] =
{
  { MRIFIX, "I",      00400   },    /* INDIRECT ADDRESSING                    */
  { MRIFIX, "Z",      00000   }     /* PAGE ZERO ADDRESS                      */
};

SYM_T permanent_symbols[] =
{
  /* Memory Reference Instructions                                            */
  { MRIFIX, "AND",    00000   },    /* LOGICAL AND                            */
  { MRIFIX, "TAD",    01000   },    /* TWO'S COMPLEMENT ADD                   */
  { MRIFIX, "ISZ",    02000   },    /* INCREMENT AND SKIP IF ZERO             */
  { MRIFIX, "DCA",    03000   },    /* DEPOSIT AND CLEAR ACC                  */
  { MRIFIX, "JMP",    05000   },    /* JUMP                                   */
  { MRIFIX, "JMS",    04000   },    /* JUMP TO SUBROUTINE                     */
  /* Floating Point Interpreter Instructions                                  */
  { MRIFIX, "FEXT",   00000   },    /* FLOATING EXIT                          */
  { MRIFIX, "FADD",   01000   },    /* FLOATING ADD                           */
  { MRIFIX, "FSUB",   02000   },    /* FLOATING SUBTRACT                      */
  { MRIFIX, "FMPY",   03000   },    /* FLOATING MULTIPLY                      */
  { MRIFIX, "FDIV",   04000   },    /* FLOATING DIVIDE                        */
  { MRIFIX, "FGET",   05000   },    /* FLOATING GET                           */
  { MRIFIX, "FPUT",   06000   },    /* FLOATING PUT                           */
  { FIXED,  "FNOR",   07000   },    /* FLOATING NORMALIZE                     */
  { FIXED,  "FEXT",   00000   },    /* EXIT FROM FLOATING POINT INTERPRETER   */
  { FIXED,  "SQUARE", 00001   },    /* SQUARE C(FAC)                          */
  { FIXED,  "SQROOT", 00002   },    /* TAKE SQUARE ROOT OF C(FAC)             */
  /* Group 1 Operate Microinstrcutions                                        */
  { FIXED,  "OPR",    07000   },    /* NO OPERATION                           */
  { FIXED,  "NOP",    07000   },    /* NO OPERATION                           */
  { FIXED,  "IAC",    07001   },    /* INCREMENT AC                           */
  { FIXED,  "RAL",    07004   },    /* ROTATE AC AND LINK LEFT ONE            */
  { FIXED,  "RTL",    07006   },    /* ROTATE AC AND LINK LEFT TWO            */
  { FIXED,  "RAR",    07010   },    /* ROTATE AC AND LINK RIGHT ONE           */
  { FIXED,  "RTR",    07012   },    /* ROTATE AC AND LINK RIGHT TWO           */
  { FIXED,  "CML",    07020   },    /* COMPLEMENT LINK                        */
  { FIXED,  "CMA",    07040   },    /* COMPLEMEMNT AC                         */
  { FIXED,  "CLL",    07100   },    /* CLEAR LINK                             */
  { FIXED,  "CLA",    07200   },    /* CLEAR AC                               */
  /* Group 2 Operate Microinstructions                                        */
  { FIXED,  "BSW",    07002   },    /* Swap bytes in AC (PDP/8e)              */
  { FIXED,  "HLT",    07402   },    /* HALT THE COMPUTER                      */
  { FIXED,  "OSR",    07404   },    /* INCLUSIVE OR SR WITH AC                */
  { FIXED,  "SKP",    07410   },    /* SKIP UNCONDITIONALLY                   */
  { FIXED,  "SNL",    07420   },    /* SKIP ON NON-ZERO LINK                  */
  { FIXED,  "SZL",    07430   },    /* SKIP ON ZERO LINK                      */
  { FIXED,  "SZA",    07440   },    /* SKIP ON ZERO AC                        */
  { FIXED,  "SNA",    07450   },    /* SKIP ON NON=ZERO AC                    */
  { FIXED,  "SMA",    07500   },    /* SKIP MINUS AC                          */
  { FIXED,  "SPA",    07510   },    /* SKIP ON POSITIVE AC (ZERO IS POSITIVE) */
  /* Combined Operate Microinstructions                                       */
  { FIXED,  "CIA",    07041   },    /* COMPLEMENT AND INCREMENT AC            */
  { FIXED,  "STL",    07120   },    /* SET LINK TO 1                          */
  { FIXED,  "GLK",    07204   },    /* GET LINK (PUT LINK IN AC BIT 11)       */
  { FIXED,  "STA",    07240   },    /* SET AC TO -1                           */
  { FIXED,  "LAS",    07604   },    /* LOAD ACC WITH SR                       */
  /* MQ Instructions (PDP/8e)                                                 */
  { FIXED,  "MQL",    07421   },    /* Load MQ from AC, then clear AC.        */
  { FIXED,  "MQA",    07501   },    /* Inclusive OR MQ with AC                */
  { FIXED,  "SWP",    07521   },    /* Swap AC and MQ                         */
  { FIXED,  "ACL",    07701   },    /* Load MQ into AC                        */
  /* Program Interrupt                                                        */
  { FIXED,  "IOT",    06000   },
  { FIXED,  "ION",    06001   },    /* TURN INTERRUPT PROCESSOR ON            */
  { FIXED,  "IOF",    06002   },    /* TURN INTERRUPT PROCESSOR OFF           */
  /* Program Interrupt, PDP-8/e                                               */
  { FIXED,  "SKON",   06000   },    /* Skip if interrupt on and turn int off. */
  { FIXED,  "SRQ",    06003   },    /* Skip on interrupt request.             */
  { FIXED,  "GTF",    06004   },    /* Get interrupt flags.                   */
  { FIXED,  "RTF",    06005   },    /* Restore interrupt flags.               */
  { FIXED,  "SGT",    06006   },    /* Skip on greater than flag.             */
  { FIXED,  "CAF",    06007   },    /* Clear all flags.                       */
  /* Keyboard/Reader                                                          */
  { FIXED,  "KCF",    06030   },    /* CLEAR KEYBOAR FLAG                     */
  { FIXED,  "KSF",    06031   },    /* SKIP ON KEYBOARD FLAG                  */
  { FIXED,  "KCC",    06032   },    /* CLEAR KEYBOARD FLAG & READ CHAR        */
  { FIXED,  "KRS",    06034   },    /* READ KEYBOARD BUFFER (STATIC)          */
  { FIXED,  "KIE",    06035   },    /* AC11 TO KEYBD/RDR INT ENABLE F/F       */
  { FIXED,  "KRB",    06036   },    /* READ KEYBOARD BUFFER & CLEAR FLAG      */
  /* Teleprinter/Punch                                                        */
  { FIXED,  "TFL",    06040   },    /* SET TELEPRINTER/PUNCH FLAG             */
  { FIXED,  "TSF",    06041   },    /* SKIP ON TELEPRINTER FLAG               */
  { FIXED,  "TCF",    06042   },    /* CLEAR TELEPRINTER FLAG                 */
  { FIXED,  "TPC",    06044   },    /* LOAD TELEPRINTER & PRINT               */
  { FIXED,  "TSK",    06045   },    /* SKIP IF TELETYPE INTERRUPT             */
  { FIXED,  "TLS",    06046   },    /* LOAD TELPRINTER & CLEAR FLAG           */
  /* High Speed Paper Tape Reader                                             */
  { FIXED,  "RSF",    06011   },    /* SKIP ON READER FLAG                    */
  { FIXED,  "RRB",    06012   },    /* READ READER BUFFER AND CLEAR FLAG      */
  { FIXED,  "RFC",    06014   },    /* READER FETCH CHARACTER                 */
  /* PC8-E High Speed Paper Tape Reader & Punch                               */
  { FIXED,  "RPE",    06010   },    /* Set interrupt enable for reader/punch  */
  { FIXED,  "PCE",    06020   },    /* Clear interrupt enable for rdr/punch   */
  { FIXED,  "RCC",    06016   },    /* Read reader buffer, clear flags & buf, */
                                    /* and fetch character.                   */
  /* High Speed Paper Tape Punch                                              */
  { FIXED,  "PSF",    06021   },    /* SKIP ON PUNCH FLAG                     */
  { FIXED,  "PCF",    06022   },    /* CLEAR ON PUNCH FLAG                    */
  { FIXED,  "PPC",    06024   },    /* LOAD PUNCH BUFFER AND PUNCH CHARACTER* */
  { FIXED,  "PLS",    06026   },    /* LOAD PUNCH BUFFER AND CLEAR FLAG       */

  /* DECassette TU60 (RK 20071008)                                            */
  { FIXED,  "KCLR",   06700   },    /* Clear all (clear A and B)              */
  { FIXED,  "KSDR",   06701   },    /* Skip if data flag set                  */
  { FIXED,  "KSEN",   06702   },    /* Skip if EOT/BOT, not ready, or empty   */
  { FIXED,  "KSBF",   06703   },    /* Skip if ready flag set                 */
  { FIXED,  "KLSA",   06704   },    /* AC4-11 -> A, clear A, -(AC4-11) -> A   */
  { FIXED,  "KSAF",   06705   },    /* Skip on any flag or error              */
  { FIXED,  "KGOA",   06706   },    /* Assert status A and transfer data to AC*/
  { FIXED,  "KRSB",   06707   },    /* Transfer B -> AC4-11                   */

  /* DECtape Transport Type TU55 and DECtape Control Type TC01                */
  { FIXED,  "DTRA",   06761   },    /* Contents of status register is ORed    */
                                    /* into AC bits 0-9                       */
  { FIXED,  "DTCA",   06762   },    /* Clear status register A, all flags     */
                                    /* undisturbed                            */
  { FIXED,  "DTXA",   06764   },    /* Status register A loaded by exclusive  */
                                    /* OR from AC.  If AC bit 10=0, clear     */
                                    /* error flags; if AC bit 11=0, DECtape   */
                                    /* control flag is cleared.               */
  { FIXED,  "DTLA",   06766   },    /* Combination of DTCA and DTXA           */
  { FIXED,  "DTSF",   06771   },    /* Skip if error flag is 1 or if DECtape  */
                                    /* control flag is 1                      */
  { FIXED,  "DTRB",   06772   },    /* Contents of status register B is       */
                                    /* ORed into AC                           */
  { FIXED,  "DTLB",   06774   },    /* Memory field portion of status         */
                                    /* register B loaded from AC bits 6-8     */
  /* Disk File and Control, Type DF32                                         */
  { FIXED,  "DCMA",   06601   },    /* CLEAR DISK MEMORY REQUEST AND          */
                                    /* INTERRUPT FLAGS                        */
  { FIXED,  "DMAR",   06603   },    /* LOAD DISK FROM AC, CLEAR AC READ       */
                                    /* INTO CORE, CLEAR INTERRUPT FLAG        */
  { FIXED,  "DMAW",   06605   },    /* LOAD DISK FROM AC, WRITE ONTO DISK     */
                                    /* FROM CORE, CLEAR INTERRUPT FLAG        */
  { FIXED,  "DCEA",   06611   },    /* CLEAR DISK EXTENDED ADDRESS AND        */
  { FIXED,  "DSAC",   06612   },    /* SKIP IF ADDRESS CONFIRMED FLAG = 1     */
                                    /* MEMORY ADDRESS EXTENSION REGISTER      */
  { FIXED,  "DEAL",   06615   },    /* CLEAR DISK EXTENDED ADDRESS AND        */
                                    /* MEMORY ADDRESS EXTENSION REGISTER      */
                                    /* AND LOAD SAME FROM AC                  */
  { FIXED,  "DEAC",   06616   },    /* CLEAR AC, LOAD AC FROM DISK EXTENDED   */
                                    /* ADDRESS REGISTER, SKIP IF ADDRESS      */
                                    /* CONFIRMED FLAG = 1                     */
  { FIXED,  "DFSE",   06621   },    /* SKIP IF PARITY ERROR, DATA REQUEST     */
                                    /* LATE, OR WRITE LOCK SWITCH FLAG = 0    */
                                    /* (NO ERROR)                             */
  { FIXED,  "DFSC",   06622   },    /* SKIP IF COMPLETION FLAG = 1 (DATA      */
                                    /* TRANSFER COMPLETE)                     */
  { FIXED,  "DMAC",   06626   },    /* CLEAR AC, LOAD AC FROM DISK MEMORY     */
                                    /* ADDRESS REGISTER                       */
  /* Disk File and Control, Type RF08                                         */
  { FIXED,  "DCIM",   06611   },
  { FIXED,  "DIML",   06615   },
  { FIXED,  "DIMA",   06616   },
  { FIXED,  "DISK",   06623   },
  { FIXED,  "DCXA",   06641   },
  { FIXED,  "DXAL",   06643   },
  { FIXED,  "DXAC",   06645   },
  { FIXED,  "DMMT",   06646   },
  /* Disk Type RK8E */
  { FIXED,  "DSKP",   06741   },    /* Disk Skip                              */
  { FIXED,  "DCLR",   06742   },    /* Disk Clear                             */
  { FIXED,  "DLAG",   06743   },    /* Disk Load and Go                       */
  { FIXED,  "DLCA",   06744   },    /* Disk Load Current Address              */
  { FIXED,  "DRST",   06745   },    /* Disk Read Status Register              */
  { FIXED,  "DLDC",   06746   },    /* Disk Load Command Register             */
  /* Memory Extension Control, Type 183                                       */
  { FIXED,  "CDF",    06201   },    /* CHANGE DATA FIELD                      */
  { FIXED,  "CIF",    06202   },    /* CHANGE INSTRUCTION FIELD               */
  { FIXED,  "CDI",    06203   },    /* Change data & instrution field.        */
  { FIXED,  "RDF",    06214   },    /* READ DATA FIELD                        */
  { FIXED,  "RIF",    06224   },    /* READ INSTRUCTION FIELD                 */
  { FIXED,  "RIB",    06234   },    /* READ INTERRUPT BUFFER                  */
  { FIXED,  "RMF",    06244   },    /* RESTORE MEMORY FIELD                   */
  /* Memory Parity, Type MP8/I (MP8/L)                                        */
  { FIXED,  "SMP",    06101   },    /* SKIP IF MEMORY PARITY FLAG = 0         */
  { FIXED,  "CMP",    06104   },    /* CLEAR MEMORY PAIRTY FLAG               */
  /* Memory Parity, Type MP8-E (PDP8/e)                                       */
  { FIXED,  "DPI",    06100   },    /* Disable parity interrupt.              */
  { FIXED,  "SNP",    06101   },    /* Skip if no parity error.               */
  { FIXED,  "EPI",    06103   },    /* Enable parity interrupt.               */
  { FIXED,  "CNP",    06104   },    /* Clear parity error flag.               */
  { FIXED,  "CEP",    06106   },    /* Check for even parity.                 */
  { FIXED,  "SPO",    06107   },    /* Skip on parity option.                 */
  /* Data Communications Systems, Type 680I                                   */
  { FIXED,  "TTINCR", 06401   },    /* The content of the line select         */
                                    /* register is incremented by one.        */
  { FIXED,  "TTI",    06402   },    /* The line status word is read and       */
                                    /* sampled.  If the line is active for    */
                                    /* the fourth time, the line bit is       */
                                    /* shifted into the character assembly    */
                                    /* word.  If the line bit is active for   */
                                    /* a number of times less than four,      */
                                    /* the count is incremented.  If the      */
                                    /* line is not active, the active/inac-   */
                                    /* tive status of the line is recorded    */
  { FIXED,  "TTO",    06404   },    /* The character in the AC is shifted     */
                                    /* right one position, zeros are shifted  */
                                    /* into vacated positions, and the orig-  */
                                    /* inal content of AC11 is transferred    */
                                    /* out of the computer on the TTY line.   */
  { FIXED,  "TTCL",   06411   },    /* The line select register is cleared.   */
  { FIXED,  "TTSL",   06412   },    /* The line select register is loaded by  */
                                    /* an OR transfer from the content of     */
                                    /* of AC5-11, the the AC is cleared.      */
  { FIXED,  "TTRL",   06414   },    /* The content of the line select regis-  */
                                    /* ter is read into AC5-11 by an OR       */
                                    /* transfer.                              */
  { FIXED,  "TTSKP",  06421   },    /* Skip if clock flag is a 1.             */
  { FIXED,  "TTXON",  06424   },    /* Clock 1 is enabled to request a prog-  */
                                    /* ram interrupt and clock 1 flag is      */
                                    /* cleared.                               */
  { FIXED,  "TTXOF",  06422   },    /* Clock 1 is disabled from causing a     */
                                    /* program interrupt and clock 1 flag     */
                                    /* is cleared.                            */
};      /* End-of-Symbols for Permanent Symbol Table                          */

/* Global variables                                                           */
SYM_T *symtab;                  /* Symbol Table                               */
int    symbol_top;              /* Number of entries in symbol table.         */

SYM_T *fixed_symbols;           /* Start of the fixed symbol table entries.   */
int    number_of_fixed_symbols;

/*----------------------------------------------------------------------------*/

WORD16 *xreftab;                /* Start of the concordance table.            */

ERRSAVE_T error_list[20];
int     save_error_count;

#define GET_PAGE_INDEX(x) (((x) & 07600) >> 7)
#define MAX_PAGES 32
LPOOL_T cp[MAX_PAGES];             /* Storage for page constants.       */
int     max_page_used[MAX_PAGES];

char   s_detected[] = "detected";
char   s_error[]    = "error";
char   s_errors[]   = "errors";
char   s_no[]       = "No";
char   s_page[]     = "Page";
char   s_symtable[] = "Symbol Table";
char   s_xref[]     = "Cross Reference";
char   s_generated[] = "generated";
char   s_link[]    = "link";
char   s_links[]   = "links";

/* Assembler diagnostic messages.                                             */
/* Some attempt has been made to keep continuity with the PAL-III and         */
/* MACRO-8 diagnostic messages.  If a diagnostic indicator, (e.g., IC)        */
/* exists, then the indicator is put in the listing as the first two          */
/* characters of the diagnostic message.  The PAL-III indicators where used   */
/* when there was a choice between using MACRO-8 and PAL-III indicators.      */
/* The character pairs and their meanings are:                                */
/*      DT  Duplicate Tag (symbol)                                            */
/*      IC  Illegal Character                                                 */
/*      ID  Illegal Redefinition of a symbol.  An attempt was made to give    */
/*          a symbol a new value not via =.                                   */
/*      IE  Illegal Equals  An equal sign was used in the wrong context,      */
/*          (e.g., A+B=C, or TAD A+=B)                                        */
/*      II  Illegal Indirect  An off page reference was made, but a literal   */
/*          could not be generated because the indirect bit was already set.  */
/*      IR  Illegal Reference (address is not on current page or page zero)   */
/*      ND  No $ (the program terminator) at end of file.                     */
/*      PE  Current, Non-Zero Page Exceeded (literal table flowed into code)  */
/*      RD  ReDefintion of a symbol                                           */
/*      ST  Symbol Table full                                                 */
/*      UA  Undefined Address (undefined symbol)                              */
/*      ZE  Zero Page Exceeded (see above, or out of space)                   */
EMSG_T  duplicate_label     = { "DT duplicate",  "duplicate label" };
EMSG_T  illegal_blank       = { "IC illegal blank", "illegal blank" };
EMSG_T  illegal_character   = { "IC illegal char",  "illegal character" };
EMSG_T  illegal_expression  = { "IC in expression", "illegal expression" };
EMSG_T  label_syntax        = { "IC label syntax",  "label syntax" };
EMSG_T  not_a_number        = { "IC numeric syntax", "numeric syntax of" };
EMSG_T  number_not_radix    = { "IC radix", "number not in current radix"};
EMSG_T  symbol_syntax       = { "IC symbol syntax", "symbol syntax" };
EMSG_T  illegal_equals      = { "IE illegal =",  "illegal equals" };
EMSG_T  illegal_indirect    = { "II off page",   "illegal indirect" };
EMSG_T  illegal_reference   = { "IR off page",   "illegal reference" };
EMSG_T  undefined_symbol    = { "UD undefined",  "undefined symbol" };
EMSG_T  redefined_symbol    = { "RD redefined",  "redefined symbol" };
EMSG_T  illegal_redefine    = { "ID redefined",  "Illegal redefine of symbol" };
EMSG_T  literal_overflow    = { "PE page exceeded",
                                   "current page literal capacity exceeded" };
EMSG_T  pz_literal_overflow = { "ZE page exceeded",
                                   "page zero capacity exceeded" };
EMSG_T  dubl_overflow       = { "dubl overflow",  "DUBL value overflow" };
EMSG_T  fltg_overflow       = { "fltg overflow",  "FLTG value overflow" };
EMSG_T  zblock_too_small    = { "expr too small", "ZBLOCK value too small" };
EMSG_T  zblock_too_large    = { "expr too large", "ZBLOCK value too large" };
EMSG_T  end_of_file         = { "ND no $ at EOF", "No $ at End-of-File" };
EMSG_T  no_pseudo_op        = { "not implemented",
                                   "not implemented pseudo-op" };
EMSG_T  illegal_field_value = { "expr out of range",
                                   "field value not in range of 0 through 7" };
EMSG_T  literal_gen_off     = { "literals off",
                                                "literal generation is off" };
EMSG_T  no_literal_value    = { "no value",  "no literal value" };
EMSG_T  text_string         = { "no delimiter",
                                    "text string delimiters not matched" };
EMSG_T  in_rim_mode         = { "not OK in rim mode"
                                    "FIELD pseudo-op not valid in RIM mode" };
EMSG_T  lt_expected         = { "'<' expected",  "'<' expected" };
EMSG_T  symbol_table_full   = { "ST Symbol Tbl Full",
                                                    "Symbol Table Full" };
/*----------------------------------------------------------------------------*/

FILE   *errorfile;
FILE   *infile;
FILE   *listfile;
FILE   *listsave;
FILE   *objectfile;
FILE   *objectsave;

char    errorpathname[NAMELEN];
char    filename[NAMELEN];
char    listpathname[NAMELEN];
char    objectpathname[NAMELEN];
char   *pathname;
char    permpathname[NAMELEN];

int     tabstops;               /* number of characters to expand a tab to   */
int     list_lineno;
int     list_pageno;
char    list_title[LINELEN];
BOOL    list_title_set;         /* Set if TITLE pseudo-op used.               */
char    line[LINELEN];          /* Input line.                                */
int     lineno;                 /* Current line number.                       */
int     page_lineno;            /* print line number on current page.         */
BOOL    listed;                 /* Listed flag.                               */
BOOL    listedsave;

int     cc;                     /* Column Counter (char position in line).    */
WORD16  checksum;               /* Generated checksum                         */
BOOL    binary_data_output;     /* Set true when data has been output.        */
WORD16  clc;                    /* Location counter                           */
WORD16  cplc;                   /* Current page literal counter.              */
char    delimiter;              /* Character immediately after eval'd term.   */
int     errors;                 /* Number of errors found so far.             */
int     links;                  /* Number of links generated so far.          */
BOOL    error_in_line;          /* TRUE if error on current line.             */
int     errors_pass_1;          /* Number of errors on pass 1.                */
WORD16  field;                  /* Current field                              */
WORD16  fieldlc;                /* location counter without field portion.    */
BOOL    fltg_input;             /* TRUE when doing floating point input.      */
BOOL    indirect_generated;     /* TRUE if an off page address generated.     */
int     last_xref_lexstart;     /* Column where last xref symbol was located. */
int     last_xref_lineno;       /* Line where last xref symbol was located.   */
int     lexstartprev;           /* Where previous lexeme started.             */
int     lextermprev;            /* Where previous lexeme ended.               */
int     lexstart;               /* Index of current lexeme on line.           */
int     lexterm;                /* Index of character after current lexeme.   */
BOOL    literals_ok;            /* Generate literals, ignore ID redefine err  */
BOOL    perm_redef_error;       /* Make redefining perm sym with labels error */
int     maxcc;                  /* Current line length.                       */
BOOL    overflow;               /* Overflow flag for math routines.           */
int     pass;                   /* Number of current pass.                    */
BOOL    print_permanent_symbols;
WORD16  pzlc;                   /* Page Zero literal counter.                 */
WORD16  radix;                  /* Default number radix.                      */
WORD16  reloc;                  /* The relocation distance.                   */
BOOL    rim_mode;               /* Generate rim format, defaults to bin       */
BOOL    dollar_not_required;    /* $ not required at end of file              */
BOOL    additional_enabled;     /* True if extended functions over PAL8       */
                                /* enabled                                    */
BOOL    symtab_print;           /* Print symbol table flag                    */
BOOL    xref;
BOOL    allowBad;		/* Allow syntax that PAL8 is ok with but is   */
                                /* bad practice and rarely used               */

FLTG_T  fltg_ac;                /* Value holder for evalFltg()                */
SYM_T   sym_eval = { DEFINED, "", 0 };       /* Value holder for eval()       */
SYM_T   sym_getexpr = { DEFINED, "", 0 };    /* Value holder for getexpr()    */
SYM_T   sym_undefined = { UNDEFINED, "", 0 };/* Symbol Table Terminator       */


/******************************************************************************/
/*                                                                            */
/*  Function:  main                                                           */
/*                                                                            */
/*  Synopsis:  Starting point.  Controls order of assembly.                   */
/*                                                                            */
/******************************************************************************/
int main( int argc, char *argv[] )
{
  int     ix;
  int     space;

  /* Set the default values for global symbols.                               */
  binary_data_output = FALSE;
  fltg_input = FALSE;
  literals_ok = TRUE;
  perm_redef_error = FALSE;
  print_permanent_symbols = FALSE;
  rim_mode = FALSE;
  dollar_not_required = FALSE;
  additional_enabled = FALSE;
  symtab_print = FALSE;
  xref = FALSE;
  allowBad = FALSE;
  pathname = NULL;

  /* Get the options and pathnames                                            */
  getArgs( argc, argv );

  /* Setup the error file in case symbol table overflows while installing the */
  /* permanent symbols.                                                       */
  errorfile = fopen( errorpathname, "w" );
  if (errorfile == NULL) {
    fprintf( stderr, "Could not open error file %s: %s\n", errorpathname, strerror(errno));
    exit( -1 );

  }
  errors = 0;
  save_error_count = 0;
  pass = 0;             /* This is required for symbol table initialization.  */
  symtab = (SYM_T *) malloc( sizeof( SYM_T ) * SYMBOL_TABLE_SIZE );

  if( symtab == NULL )
  {
    fprintf( stderr, "Could not allocate memory for symbol table.\n");
    exit( -1 );
  }

  /* Place end marker in symbol table.                                        */
  symtab[0] = sym_undefined;
  symbol_top = 0;
  number_of_fixed_symbols = symbol_top;
  fixed_symbols = &symtab[symbol_top - 1];

  /* Enter the pseudo-ops into the symbol table                               */
  for( ix = 0; ix < DIM( pseudo ) - 
        (additional_enabled ? 0 : NUMBER_ADDITIONAL_PSEUDO) ; ix++ )
  {
    defineSymbol( pseudo[ix].name, pseudo[ix].val, pseudo[ix].type, 0 );
  }

  /* Enter the predefined symbols into the table.                             */
  /* Also make them part of the permanent symbol table.                       */
  for( ix = 0; ix < DIM( really_permanent_symbols ); ix++ )
  {
    defineSymbol( really_permanent_symbols[ix].name,
                  really_permanent_symbols[ix].val,
                  really_permanent_symbols[ix].type | DEFFIX , 0 );
  }

  /* Enter the predefined symbols into the table.                             */
  /* Also make them part of the permanent symbol table.                       */
  for( ix = 0; ix < DIM( permanent_symbols ); ix++ )
  {
    defineSymbol( permanent_symbols[ix].name,
                  permanent_symbols[ix].val,
                  permanent_symbols[ix].type | DEFFIX , 0 );
  }

  number_of_fixed_symbols = symbol_top;
  fixed_symbols = &symtab[symbol_top - 1];

  /* Do pass one of the assembly                                              */
  checksum = 0;
  pass = 1;
  page_lineno = LIST_LINES_PER_PAGE;
  onePass();
  errors_pass_1 = errors;

  /* Set up for pass two                                                      */
  rewind( infile );
  /*Opened in main errorfile = fopen( errorpathname, "w" );*/
  objectfile = fopen( objectpathname, "wb" );
  if (objectfile == NULL) {
    fprintf( stderr, "Could not open object file %s: %s\n", objectpathname, strerror(errno));
    exit( -1 );

  }
  objectsave = objectfile;

  listfile = fopen( listpathname, "w" );
  if (listfile == NULL) {
    fprintf( stderr, "Could not open list file %s: %s\n", listpathname, strerror(errno));
    exit( -1 );

  }
  listsave = NULL;

  punchLeader( 0 );
  checksum = 0;

  /* Do pass two of the assembly                                              */
  errors = 0;
  save_error_count = 0;
  page_lineno = LIST_LINES_PER_PAGE;

  if( xref )
  {
    /* Get the amount of space that will be required for the concordance.     */
    for( space = 0, ix = 0; ix < symbol_top; ix++ )
    {
      symtab[ix].xref_index = space;    /* Index into concordance table.      */
      space += symtab[ix].xref_count + 1;
      symtab[ix].xref_count = 0;        /* Clear the count for pass 2.        */

    }
    /* Allocate the necessary space.                                          */
    xreftab = (WORD16 *) malloc( sizeof( WORD16 ) * space );

    /* Clear the cross reference space.                                       */
    for( ix = 0; ix < space; ix++ )
    {
      xreftab[ix] = 0;
    }
  }
  pass = 2;
  onePass();

  /* Undo effects of NOPUNCH for any following checksum                       */
  objectfile = objectsave;
  punchChecksum();

  /* Works great for trailer.                                                 */
  punchLeader( 8 );

  /* undo effects of XLIST for any following output to listing file.          */
  if( listfile == NULL )
  {
    listfile = listsave;
  }

  /* Display value of error counter.                                          */
  if( errors == 0 )
  {
    fprintf( listfile, "\n      %s %s %s\n", s_no, s_detected, s_errors );
  }
  else
  {
    fprintf( errorfile, "\n      %d %s %s\n", errors, s_detected,
                                        ( errors == 1 ? s_error : s_errors ));
    fprintf( listfile, "\n      %d %s %s\n", errors, s_detected,
                                        ( errors == 1 ? s_error : s_errors ));
    fprintf( stderr,   "      %d %s %s\n", errors, s_detected,
                                        ( errors == 1 ? s_error : s_errors ));
  }
  /* Display value of link counter.                                          */
  if( links == 0 )
  {
    fprintf( listfile, "      %s %s %s\n", s_no, s_links, s_generated );
  }
  else
  {
    fprintf( errorfile, "      %d %s %s\n", links, 
                                        ( links == 1 ? s_link : s_links ), 
                                        s_generated);
    fprintf( listfile, "      %d %s %s\n", links, 
                                        ( links == 1 ? s_link : s_links ), 
                                        s_generated);
    fprintf( stderr, "      %d %s %s\n", links, 
                                        ( links == 1 ? s_link : s_links ), 
                                        s_generated);
  }

  if( symtab_print )
  {
    printSymbolTable();
  }

  if( print_permanent_symbols )
  {
    printPermanentSymbolTable();
  }

  if( xref )
  {
    printCrossReference();
  }

  fclose( objectfile );
  fclose( listfile );
  fclose( errorfile );
  if( errors == 0 && errors_pass_1 == 0 )
  {
    remove( errorpathname );
  }

  return( errors != 0 );
} /* main()                                                                   */

/******************************************************************************/
/*                                                                            */
/*  Function:  getArgs                                                        */
/*                                                                            */
/*  Synopsis:  Parse command line, set flags accordingly and setup input and  */
/*             output files.                                                  */
/*                                                                            */
/******************************************************************************/
void getArgs( int argc, char *argv[] )
{
  int  len;
  int  ix, jx;

  /* Set the defaults                                                         */
  errorfile = NULL;
  infile = NULL;
  listfile = NULL;
  listsave = NULL;
  objectfile = NULL;
  objectsave = NULL;
  tabstops = 8;

  for( ix = 1; ix < argc; ix++ )
  {
    if( argv[ix][0] == '-' )
    {
      for( jx = 1; argv[ix][jx] != 0; jx++ )
      {
        switch( argv[ix][jx] )
        {
        case '$':
          dollar_not_required = TRUE;
          break;

        case 'd':
          symtab_print = TRUE;
          break;

        case 'a':
          additional_enabled = TRUE;
          break;

        case 'r':
          rim_mode = TRUE;
          break;

        case 'e':
          literals_ok = FALSE;
          break;

        case 'l':
          literals_ok = TRUE;
          break;

        case 'n':
          perm_redef_error = TRUE;
          break;

        case 'p':
          print_permanent_symbols = TRUE;
          break;

        /* Added -tN; RK 20071029 */
        /* Damn, this is ugly, we should use getopt() */
        case 't':
          if (argv [ix][jx + 1]) {
            tabstops = atoi (argv [ix] + (jx + 1));
            /* advance past numbers */
            for (jx++; argv [ix][jx]; jx++) ;
            jx--;
          } else {
            ix++;
            if (ix >= argc) {
              fprintf( stderr, "%s: missing argument for -t, expected number of tabsopts\n", argv[0] );
              exit( -1 );
            }
            for (jx = 0; argv [ix][jx]; jx++) ;
            jx--;
            tabstops = atoi (argv [ix]);
          }
          break;

        case 'x':
          xref = TRUE;
          break;

        case 'v':
          fprintf( stderr, "%s\n", release );
          fflush( stderr );
          exit( -1 );
          break;

        case 'b':
          allowBad = TRUE;
          break;

        default:
          fprintf( stderr, "%s: unknown flag: %s\n", argv[0], argv[ix] );
        case 'h':
          fprintf( stderr, " -$ -- allow file to not end with $\n" );
          fprintf( stderr, " -a -- enable additional function not in PAL8\n" );
          fprintf( stderr, " -d -- dump symbol table\n" );
          fprintf( stderr, " -e -- error if link generated\n" );
          fprintf( stderr, " -h -- show this help\n" );
          fprintf( stderr, " -l -- generate literal/link (default)\n" );
          fprintf( stderr, " -n -- no redefining with label permanent symbols\n" );
          fprintf( stderr, " -p -- output permanent symbols to file\n" );
          fprintf( stderr, " -r -- output rim format file\n" );
          fprintf( stderr, " -t N -- set tab stops to N\n" );
          fprintf( stderr, " -v -- display version\n" );
          fprintf( stderr, " -x -- output cross reference to file\n" );
          fflush( stderr );
          exit( -1 );
        } /* end switch                                                       */
      } /* end for                                                            */
    }
    else
    {
      if( pathname != NULL )
      {
        fprintf( stderr, "%s: too many input files\n", argv[0] );
        exit( -1 );
      }
      pathname = &argv[ix][0];
    }
  } /* end for                                                                */

  if( pathname == NULL )
  {
    fprintf( stderr, "%s:  no input file specified\n", argv[0] );
    exit( -1 );
  }

  len = strlen( pathname );
  if( len > NAMELEN - 5 )
  {
    fprintf( stderr, "%s: pathname \"%s\" too long\n", argv[0], pathname );
    exit( -1 );
  }

  /* Now open the input file.                                                 */
  if(( infile = fopen( pathname, "r" )) == NULL )
  {
    fprintf( stderr, "%s: cannot open \"%s\": %s\n", argv[0], pathname, strerror(errno) );
    exit( -1 );
  }

  /* Now make the pathnames                                                   */
  /* Find last '.', if it exists.                                             */
  jx = len - 1;
  while( pathname[jx] != '.'  && pathname[jx] != '/'
      && pathname[jx] != '\\' && jx >= 0 )
  {
    jx--;
  }

  switch( pathname[jx] )
  {
  case '.':
    break;

  case '/':
  case '\\':
    jx = len;
    break;

  default:
    break;
  }

  /* Add the pathname extensions.                                             */
  strncpy( objectpathname, pathname, jx );
  objectpathname[jx] = '\0';
  strcat( objectpathname, rim_mode ? ".rim" : ".bin" );

  strncpy( listpathname, pathname, jx );
  listpathname[jx] = '\0';
  strcat( listpathname, ".lst" );

  strncpy( errorpathname, pathname, jx );
  errorpathname[jx] = '\0';
  strcat( errorpathname, ".err" );

  strncpy( permpathname, pathname, jx );
  permpathname[jx] = '\0';
  strcat( permpathname, ".prm" );

  /* Extract the filename from the path.                                      */
  if( isalpha( pathname[0] ) && pathname[1] == ':' && pathname[2] != '\\' )
  {
    pathname[1] = '\\';         /* MS-DOS style pathname                      */
  }

  jx = len - 1;
  while( pathname[jx] != '/' && pathname[jx] != '\\' && jx >= 0 )
  {
    jx--;
  }
  strcpy( filename, &pathname[jx + 1] );

} /* getArgs()                                                                */

/******************************************************************************/
/*                                                                            */
/*  Function:  clearLiteralTable                                              */
/*                                                                            */
/*  Synopsis:  Clear the cp and max_page_used data storing literal            */
/*             information.                                                   */
/*                                                                            */
/******************************************************************************/
void clearLiteralTable()
{
  int i;

  for (i = 0; i < DIM(cp); i++)
  {
    cp[i].loc = 0200;             /* Points to end of page for [] operands.  */
    cp[i].last_punched = 0200;    /* Points to end of page for [] operands.  */
  }
  memset(max_page_used, 0, sizeof(max_page_used));
}

/******************************************************************************/
/*                                                                            */
/*  Function:  onePass                                                        */
/*                                                                            */
/*  Synopsis:  Do one assembly pass.                                          */
/*                                                                            */
/******************************************************************************/
void onePass()
{
  char    name[SYMLEN];
  WORD16  newclc;
  BOOL    scanning_line;
  int     start;
  SYM_T  *sym;
  int     term;
  WORD16  val;

  clc = 0200;                   /* Default starting address is 200 octal.     */
  field = 0;
  fieldlc = clc & 07777;
  reloc = 0;
  clearLiteralTable();
  listed = TRUE;
  lineno = 0;
  list_pageno = 0;
  list_lineno = 0;
  last_xref_lexstart = 0;
  last_xref_lineno = 0;
  list_title_set = FALSE;
  radix = 8;                    /* Initial radix is octal (base 8).           */

  if( !rim_mode )
  {
    /* Put out initial origin if not in rim mode.                             */
    punchOrigin( clc );
  }

  while( TRUE )
  {
    readLine();
    nextLexeme();

    scanning_line = TRUE;
    while( scanning_line )
    {
      if( isend( line[lexstart] ))
      {
        scanning_line = FALSE;
      }
      else
      {
        switch( line[lexstart] )
        {
        case '/':
          scanning_line = FALSE;
          break;

        case ';':
          nextLexeme();
          break;

        case '$':
          endOfBinary();
          return;

        case '*':
          nextLexeme();             /* Skip '*', (set origin symbol)          */
          newclc = ((getExpr())->val & 07777 ) | field;
          /* Do not change Current Location Counter if an error occurred.     */
          if( !error_in_line )
          {
            if(( newclc & 07600 ) != ( clc & 07600 ) ) 
            {
              /* Current page has changed.                                    */
              punchLiteralPool( cp, 0 );
            }
            clc = newclc - reloc;
            fieldlc = clc & 07777;

            if( !rim_mode )
            {
              /* Not rim mode, put out origin.                                */
              punchOrigin( clc );
            }
            printLine( line, 0, fieldlc, LINE_VAL );
          }
          break;

        default:
          switch( line[lexterm] )
          {
          case ',':
            if( isalpha( line[lexstart] ))
            {
              /* Use lookup so symbol will not be counted as reference.       */
              sym = lookup( lexemeToName( name, lexstart, lexterm ));
              if( M_DEFINED( sym->type ))
              {
                if( (sym->val & 07777) != ( ( clc+reloc ) & 07777) && pass == 2 )
                {
                  errorSymbol( &duplicate_label, sym->name, lexstart );
                }
                sym->type = sym->type | DUPLICATE;
              }
              /* Must call define on pass 2 to generate concordance.          */
              defineLexeme( lexstart, lexterm, ( clc + reloc ), LABEL );
            }
            else
            {
              errorLexeme( &label_syntax, lexstart );
            }
            nextLexeme();           /* skip label                             */
            nextLexeme();           /* skip comma                             */
            break;

          case '=':
            if( isalpha( line[lexstart] ))
            {
              start = lexstart;
              term = lexterm;
              delimiter = line[lexterm];
              nextLexBlank();       /* skip symbol                            */
              nextLexeme();         /* skip trailing =, allow blank           */
              delimiter = line[lexterm];
              val = getExprs();
              defineLexeme( start, term, val, DEFINED );
              printLine( line, 0, val, LINE_VAL );
            }
            else
            {
              errorLexeme( &symbol_syntax, lexstartprev );
              nextLexeme();         /* skip symbol                            */
              nextLexeme();         /* skip trailing =                        */
              getExprs();           /* skip expression                        */
            }
            break;

          default:
            if( isalpha( line[lexstart] ))
            {
              sym = evalSymbol();
              val = sym->val;
              if( M_PSEUDO( sym->type ))
              {
                nextLexeme();         /* Skip symbol                          */
                scanning_line = pseudoOperators( (PSEUDO_T)val & 07777 );
              }
              else
              {
                /* Identifier is not a pseudo-op, interpret as load value     */
                punchOutObject( clc, getExprs() & 07777 );
                incrementClc();
              }
            }
            else
            {
              /* Identifier is a value, interpret as load value               */
              punchOutObject( clc, getExprs() & 07777 );
              incrementClc();
            }
            break;
          } /* end switch                                                     */
          break;
        } /* end switch                                                       */
      } /* end if                                                             */
    } /* end while( scanning_line )                                           */
  } /* end while( TRUE )                                                      */
} /* onePass()                                                                */


/******************************************************************************/
/*                                                                            */
/*  Function:  fixMRIInstruction                                              */
/*                                                                            */
/*  Synopsis:  Now that we have the final value figure out if page 0, current */
/*             page, or indirect needed and max final instruction             */
/*                                                                            */
/******************************************************************************/
WORD16 fixMRIInstruction(WORD16 instruction, WORD16 value)
{
        /* Now have the address part of the MRI instruction.                  */
        if( value < 00200 )
        {
          instruction |= value;        /* Page zero MRI.                             */
        }
        else if( (( fieldlc + reloc ) & 07600 ) <= value
             && value <= ((( fieldlc + reloc ) & 07600) | 0177 ))
        {
          instruction |= ( PAGE_BIT | (value & ADDRESS_FIELD )); /* Current page MRI */
        }
        else
        {
          if(( instruction & INDIRECT_BIT ) == INDIRECT_BIT )
          {
            /* Already indirect, can't generate                               */
            errorSymbol( &illegal_indirect, NULL, lexstartprev );
          }
          else
          {
            if( literals_ok )
            {
              /* Now fix off page reference.                                  */
              /* Search current page literal pool for needed instruction.           */
              /* Set Indirect Current Page                                    */
              instruction |= ( 00600 | insertLiteral( cp, value, GET_PAGE_INDEX(clc) ));
              indirect_generated = TRUE;
              if (pass == 2)
              {
                links++;
              }
            }
            else
            {
              errorSymbol( &illegal_reference, NULL, lexstartprev );
              instruction |= ( value & 0177 );
            }
          }
        }
   return instruction;
}
/******************************************************************************/
/*                                                                            */
/*  Function:  getExprs                                                       */
/*                                                                            */
/*  Synopsis:  Or together a list of blank separated expressions, from the    */
/*             current lexeme onward.  Leave the current lexeme as            */
/*             the last one in the list.                                      */
/*                                                                            */
/******************************************************************************/
WORD16 getExprs()
{
  SYM_T  *symv;
  SYM_T  *symt;
  WORD16  temp;
  SYMTYP  temp_type;
  WORD16  value;
  SYMTYP  value_type;
  BOOL    MRI_held = FALSE;
  WORD16  held_value = 0;

  symv = getExpr();
  value = symv->val;
  value_type = symv->type;

  while( TRUE )
  {
    if( isdone( line[lexstart] ))
    {
      if (MRI_held)
      {
        value = fixMRIInstruction(value, held_value);
      }
      return( value );
    }
    switch( line[lexstart] )
    {
    case ')':
    case ']':
    case '<':
      if (MRI_held)
      {
        value = fixMRIInstruction(value, held_value);
      }
      return( value );

    default:
      break;
    }

    /* Interpret space as logical or                                          */
    symt = getExpr();
    temp = symt->val & 07777;
    temp_type = symt->type;

    switch( value_type & (MRI | MRIFIX))
    {
    case MRI:
    case MRIFIX:
      /* Previous symbol was a Memory Reference Instruction.                  */
      switch( temp_type & (MRI | MRIFIX) )
      {
      case MRI:
      case MRIFIX:
        /* If we have held value don't or in more MRI's to instuction, they */
        /* are now instuction value */
        if (MRI_held)
        {
          held_value |= temp;
        }
        else
        { 
          /* Current symbol is also a Memory Reference Instruction.           */
          value |= temp;          /* Just OR the MRI instructions.            */
        }
        break;

      default:
        held_value |= temp;
        MRI_held = TRUE;
        break;
      }
      break;

    default:
        if (value_type == UNDEFINED || temp_type == UNDEFINED) {
            value = 0;
        } else {
            value |= temp;          /* Normal 12 bit value.                       */
         }
        break;
    }
  } /* end while                                                              */
} /* getExprs()                                                               */


/******************************************************************************/
/*                                                                            */
/*  Function:  getExpr                                                        */
/*                                                                            */
/*  Synopsis:  Get an expression, from the current lexeme onward, leave the   */
/*             current lexeme as the one after the expression.  Expressions   */
/*             contain terminal symbols (identifiers) separated by operators. */
/*                                                                            */
/******************************************************************************/
SYM_T *getExpr()
{
  SYM_T *sym;
  delimiter = line[lexterm];


  if( line[lexstart] == '-' )
  {
    nextLexBlank();
    sym_getexpr = *(eval());
    sym_getexpr.val = ( - sym_getexpr.val ) & 07777;
  }
  else
  {
    if( line[lexstart] == '+' )
    {
      nextLexBlank();
    }
    sym_getexpr = *(eval());
    sym_getexpr.val = sym_getexpr.val & 07777;
  }

  if( is_blank( delimiter ))
  {
    return( &sym_getexpr );
  }

  /* Here we assume the current lexeme is the operator separating the         */
  /* previous operator from the next, if any.                                 */
  while( TRUE )
  {
    /* assert line[lexstart] == delimiter                                     */
    if( is_blank( delimiter ))
    {
      return( &sym_getexpr );
    }

    switch( line[lexstart] )
    {
    case '+':                   /* add                                        */
      nextLexBlank();           /* skip over the operator                     */
      sym = eval();
      sym_getexpr.val += sym->val;
      if (sym_getexpr.type == UNDEFINED || sym->type == UNDEFINED) {
         sym_getexpr.val = 0;
         sym_getexpr.type = UNDEFINED;
      }
      break;

    case '-':                   /* subtract                                   */
      nextLexBlank();           /* skip over the operator                     */
      sym = eval();
      sym_getexpr.val -= sym->val;
      if (sym_getexpr.type == UNDEFINED || sym->type == UNDEFINED) {
         sym_getexpr.val = 0;
         sym_getexpr.type = UNDEFINED;
      }
      break;

    case '^':                   /* multiply                                   */
      nextLexBlank();           /* skip over the operator                     */
      sym = eval();
      sym_getexpr.val *= sym->val;
      if (sym_getexpr.type == UNDEFINED || sym->type == UNDEFINED) {
         sym_getexpr.val = 0;
         sym_getexpr.type = UNDEFINED;
      }
      break;

    case '%':                   /* divide                                     */
      nextLexBlank();           /* skip over the operator                     */
      sym = eval();
      sym_getexpr.val /= sym->val;
      if (sym_getexpr.type == UNDEFINED || sym->type == UNDEFINED) {
         sym_getexpr.val = 0;
         sym_getexpr.type = UNDEFINED;
      }
      break;

    case '&':                   /* and                                        */
      nextLexBlank();           /* skip over the operator                     */
      sym = eval();
      sym_getexpr.val &= sym->val;
      if (sym_getexpr.type == UNDEFINED || sym->type == UNDEFINED) {
         sym_getexpr.val = 0;
         sym_getexpr.type = UNDEFINED;
      }
      break;

    case '!':                   /* or                                         */
      nextLexBlank();           /* skip over the operator                     */
      sym = eval();
      sym_getexpr.val |= sym->val;
      if (sym_getexpr.type == UNDEFINED || sym->type == UNDEFINED) {
         sym_getexpr.val = 0;
         sym_getexpr.type = UNDEFINED;
      }
      break;

    default:
      if( isend( line[lexstart] ))
      {
        return( &sym_getexpr );
      }

      switch( line[lexstart] )
      {
      case '/':
      case ';':
      case ')':
      case ']':
      case '<':
        break;

      case '=':
        errorMessage( &illegal_equals, lexstart );
        moveToEndOfLine();
        sym_getexpr.val = 0;
        break;

      default:
        errorMessage( &illegal_expression, lexstart );
        moveToEndOfLine();
        sym_getexpr.val = 0;
        break;
      }
      return( &sym_getexpr );
    }
  } /* end while                                                              */
} /* getExpr()                                                                */


/******************************************************************************/
/*                                                                            */
/*  Function:  eval                                                           */
/*                                                                            */
/*  Synopsis:  Get the value of the current lexeme, set delimiter and advance.*/
/*                                                                            */
/******************************************************************************/
SYM_T *eval()
{
  WORD16  digit;
  int     from;
  WORD16  loc;
  SYM_T  *sym;
  WORD16  val;

  val = 0;

  delimiter = line[lexterm];
  if( isalpha( line[lexstart] ))
  {
    sym = evalSymbol();
    if( M_UNDEFINED( sym->type ) && pass == 2 )
    {
      errorSymbol( &undefined_symbol, sym->name, lexstart );
      nextLexeme();
      return( sym );
    }
    else
    {
      nextLexeme();
      return( sym );
    }
  }
  else if( isdigit( line[lexstart] ))
  {
    from = lexstart;
    val = 0;
    while( from < lexterm )
    {
      if( isdigit( line[from] ))
      {
        digit = (WORD16) line[from++] - (WORD16) '0';
        if( digit < radix )
        {
          val = val * radix + digit;
        }
        else
        {
          errorLexeme( &number_not_radix, from - 1 );
          val = 0;
          from = lexterm;
        }
      }
      else
      {
        errorLexeme( &not_a_number, lexstart );
        val = 0;
        from = lexterm;
      }
    }
    nextLexeme();
    sym_eval.val = val;
    return( &sym_eval );
  }
  else
  {
    switch( line[lexstart] )
    {
    case '"':                   /* Character literal                          */
      if( cc + 1 <= maxcc )
      {
        val = line[lexstart + 1] | 0200;
        delimiter = line[lexstart + 2];
        cc = lexstart + 2;
      }
      else
      {
        errorMessage( &no_literal_value, lexstart );
      }
      nextLexeme();
      break;

    case '.':                   /* Value of Current Location Counter          */
      val = (clc & 07777) + reloc;
      nextLexeme();
      break;

    case '[':                   /* Generate literal on page zero.             */
      if( !literals_ok && LITERAL_ERROR)
      {
        errorMessage( &literal_gen_off, lexstart );
      }
      nextLexBlank();           /* Skip bracket                               */
      val = getExprs() & 07777;

      if( line[lexstart] == ']' )
      {
        nextLexBlank();         /* Skip end bracket                           */
      }

      sym_eval.val = (literals_ok || !LITERAL_ERROR) ? insertLiteral( cp , val,
        GET_PAGE_INDEX(field)) : 0;
      return( &sym_eval );

    case '(':                   /* Generate literal on current page.          */
      if( !literals_ok && LITERAL_ERROR)
      {
        errorMessage( &literal_gen_off, lexstart );
      }

      /* PAL8 allows blanks after (  DJG 20240102 */
      if( allowBad )
      {
        nextLexeme() ;          /* Skip paren                                 */
      }
      else
      {
        nextLexBlank();         /* Skip paren                                 */
      }
      val = getExprs() & 07777;

      if( line[lexstart] == ')' )
      {
        nextLexBlank();         /* Skip end paren                             */
      }

      loc = (literals_ok || !LITERAL_ERROR) ? insertLiteral( cp, val, GET_PAGE_INDEX(clc) ) : 0;
      sym_eval.val = loc + (( clc + reloc ) & 077600 );
      return( &sym_eval );

    default:
      switch( line[lexstart] )
      {
      case '=':
        errorMessage( &illegal_equals, lexstart );
        moveToEndOfLine();
        break;

      default:
        errorMessage( &illegal_character, lexstart );
        break;
      }
      val = 0;                  /* On error, set value to zero.               */
      nextLexBlank();           /* Go past illegal character.                 */
    }
  }
  sym_eval.val = val;
  return( &sym_eval );
} /* eval()                                                                   */


/******************************************************************************/
/*                                                                            */
/*  Function:  inputDubl                                                      */
/*                                                                            */
/*  Synopsis:  Get the value of the current lexeme as a double word.          */
/*                                                                            */
/******************************************************************************/
void inputDubl()
{
  WORD32 dublvalue;
  BOOL   scanning_line;

  scanning_line = TRUE;
  do
  {
    while( scanning_line )
    {
      if( isend( line[lexstart] ))
      {
        scanning_line = FALSE;
      }
      else
      {
        switch( line[lexstart] )
        {
        case '/':
          scanning_line = FALSE;
          break;

        case ';':
          nextLexeme();
          break;

        case '+':
          delimiter = line[lexterm];
          nextLexBlank();
        case '-':
        default:
          if( isdigit( line[lexstart] ) || line[lexstart] == '-' )
          {
            dublvalue = getDublExprs();
            punchOutObject( clc, (WORD16)(( dublvalue >> 12 ) & 07777 ));
            incrementClc();
            punchOutObject( clc, (WORD16)( dublvalue & 07777 ));
            incrementClc();
          }
          else
          {
            return;             /* Non-numeric input, back to assembly.       */
          }
          break;
        } /* end switch                                                       */
      } /* end if                                                             */

      if( error_in_line )
      {
        return;                 /* Error occurred, exit DUBL input mode.      */
      }
    } /* end while( scanning_line )                                           */
    readLine();
    nextLexeme();
    scanning_line = TRUE;
  }
  while( TRUE );
} /* inputDubl()                                                              */


/******************************************************************************/
/*                                                                            */
/*  Function:  getDublExprs                                                   */
/*                                                                            */
/*  Synopsis:  Get a DUBL expression.                                         */
/*                                                                            */
/******************************************************************************/
WORD32 getDublExprs()
{
  WORD32 dublvalue;

  dublvalue = getDublExpr();

  while( TRUE )
  {
    if( isdone( line[lexstart] ))
    {
      return( dublvalue );
    }
    else
    {
      errorMessage( &illegal_expression, lexstart - 1 );
      return( 0 );
    }
  } /* end while                                                              */
} /* getDublExprs()                                                           */


/******************************************************************************/
/*                                                                            */
/*  Function:  getDublExpr                                                    */
/*                                                                            */
/*  Synopsis:  Get the value of the current lexeme as a double word.  The     */
/*             number is always considered to have a decimal radix.           */
/*                                                                            */
/******************************************************************************/
WORD32 getDublExpr()
{
  WORD32 dublvalue;

  delimiter = line[lexterm];
  if( line[lexstart] == '-' )
  {
    nextLexBlank();
    dublvalue = evalDubl( 0 );
    nextLexeme();
    /* Test for any value greater than 23 bits in length.                     */
    if( (unsigned long int)dublvalue > 040000000L )
    {
      errorMessage( &dubl_overflow, lexstart );
      dublvalue = 0;
    }
    dublvalue = -dublvalue;
  }
  else
  {
    dublvalue = evalDubl( 0 );
    nextLexeme();
    /* Test for any value greater than 23 bits in length.                     */
    if( (unsigned long int)dublvalue > 037777777L )
    {
      errorMessage( &dubl_overflow, lexstart );
      dublvalue = 0;
    }
  }

  if( is_blank( delimiter ))
  {
    return( dublvalue );
  }

  /* Here we assume the current lexeme is the operator separating the         */
  /* previous operator from the next, if any.                                 */
  while( TRUE )
  {
    /* assert line[lexstart] == delimiter                                     */
    if( is_blank( delimiter ))
    {
      errorMessage( &illegal_expression, lexstart );
      moveToEndOfLine();
      dublvalue = 0;
      return( dublvalue );
    }

    switch( line[lexstart] )
    {
    case '+':                   /* add                                        */
    case '-':                   /* subtract                                   */
    case '^':                   /* multiply                                   */
    case '%':                   /* divide                                     */
    case '&':                   /* and                                        */
    case '!':                   /* or                                         */
      errorMessage( &illegal_expression, lexstart );
      moveToEndOfLine();
      dublvalue = 0;
      break;

    default:
      if( isend( line[lexstart] ))
      {
        return( dublvalue );
      }

      switch( line[lexstart] )
      {
      case '/':
      case ';':
        break;

      default:
        errorMessage( &illegal_expression, lexstart );
        moveToEndOfLine();
        dublvalue = 0;
        break;
      }
      return( dublvalue );
    }
  } /* end while                                                              */
} /* getDublExpr()                                                            */


/******************************************************************************/
/*                                                                            */
/*  Function:  evalDubl                                                       */
/*                                                                            */
/*  Synopsis:  Get the value of the current lexeme as a double word.  The     */
/*             number is always considered to have a decimal radix.           */
/*                                                                            */
/******************************************************************************/
WORD32 evalDubl( WORD32 initial_value )
{
  WORD32  digit;
  int     from;
  WORD32  dublvalue;
  WORD32  olddublvalue;

  overflow = FALSE;
  delimiter = line[lexterm];
  from = lexstart;
  dublvalue = initial_value;

  while( from < lexterm )
  {
    if( isdigit( line[from] ))
    {
      olddublvalue = dublvalue;
      digit = (WORD32)( line[from++] - '0' );
      dublvalue = dublvalue * 10 + digit;
      if( dublvalue < olddublvalue )
      {
        overflow = TRUE;
      }
    }
    else
    {
      errorLexeme( &not_a_number, from );
      dublvalue = 0;
      from = lexterm;
    }
  }
  return( dublvalue );
} /* evalDubl()                                                               */


/******************************************************************************/
/*                                                                            */
/*  Function:  inputFltg                                                      */
/*                                                                            */
/*  Synopsis:  Get the value of the current lexeme as a Floating Point const. */
/*                                                                            */
/******************************************************************************/
void inputFltg()
{
  FLTG_T *fltg;
  BOOL    scanning_line;

  fltg_input = TRUE;            /* Set lexeme scanner for floating point.     */
  scanning_line = TRUE;
  while( TRUE )
  {
    while( scanning_line )
    {
      if( isend( line[lexstart] ))
      {
        scanning_line = FALSE;
      }
      else
      {
        switch( line[lexstart] )
        {
        case '/':
          scanning_line = FALSE;
          break;

        case ';':
          nextLexeme();
          break;

        case '+':
          delimiter = line[lexterm];
          nextLexBlank();
        case '-':
        default:
          if( isdigit( line[lexstart] ) || line[lexstart] == '-' )
          {
            fltg = getFltgExprs();
            if (!fltg)
            {
              return;             /* Erroneous input                          */
            }
            punchOutObject( clc, ( fltg->exponent & 07777 ));
            incrementClc();
            punchOutObject( clc, (WORD16)(( fltg->mantissa >> 12 ) & 07777 ));
            incrementClc();
            punchOutObject( clc, (WORD16)( fltg->mantissa & 07777 ));
            incrementClc();
          }
          else
          {
            fltg_input = FALSE; /* Reset lexeme scanner.                      */
            return;             /* Non-numeric input, back to assembly.       */
          }
          break;
        } /* end switch                                                       */
      } /* end if                                                             */

      if( error_in_line )
      {
        fltg_input = FALSE;     /* Reset lexeme scanner.                      */
        return;                 /* Error occurred, exit FLTG input mode.      */
      }
    } /* end while( scanning_line )                                           */
    readLine();
    nextLexeme();
    scanning_line = TRUE;
  }
} /* inputFltg()                                                              */


/******************************************************************************/
/*                                                                            */
/*  Function:  getFltgExprs                                                   */
/*                                                                            */
/*  Synopsis:  Get a FLTG expression.                                         */
/*                                                                            */
/******************************************************************************/
FLTG_T *getFltgExprs()
{
  FLTG_T *fltg;

  fltg = getFltgExpr();

  while( TRUE )
  {
    if( isdone( line[lexstart] ))
    {
      return( fltg );
    }
    else
    {
      errorMessage( &illegal_expression, lexstart - 1 );
      return( 0 );
    }
  } /* end while                                                              */
} /* getFltgExprs()                                                           */


/******************************************************************************/
/*                                                                            */
/*  Function:  getFltgExpr                                                    */
/*                                                                            */
/*  Synopsis:  Get the value of the current lexeme as a double word.  The     */
/*             number is always considered to have a decimal radix.           */
/*                                                                            */
/******************************************************************************/
FLTG_T *getFltgExpr()
{
  FLTG_T *fltg;

  delimiter = line[lexterm];
  fltg = evalFltg();
  /* Test for any value greater than 23 bits in length.                     */
  if( (unsigned long int)fltg->mantissa> 077777777L )
  {
    errorMessage( &fltg_overflow, lexstart );
  }

  if( is_blank( delimiter ))
  {
    return( fltg );
  }

  /* Here we assume the current lexeme is the operator separating the         */
  /* previous operator from the next, if any.                                 */
  while( TRUE )
  {
    /* assert line[lexstart] == delimiter                                     */
    if( is_blank( delimiter ))
    {
      errorMessage( &illegal_expression, lexstart );
      moveToEndOfLine();
      fltg = 0;
      return( fltg );
    }

    switch( line[lexstart] )
    {
    case '+':                   /* add                                        */
    case '-':                   /* subtract                                   */
    case '^':                   /* multiply                                   */
    case '%':                   /* divide                                     */
    case '&':                   /* and                                        */
    case '!':                   /* or                                         */
      errorMessage( &illegal_expression, lexstart );
      moveToEndOfLine();
      fltg = NULL;
      break;

    default:
      if( isend( line[lexstart] ))
      {
        return( fltg );
      }

      switch( line[lexstart] )
      {
      case '/':
      case ';':
        break;

      default:
        errorMessage( &illegal_expression, lexstart );
        moveToEndOfLine();
        fltg = NULL;
        break;
      }
      return( fltg );
    }
  } /* end while                                                              */
} /* getFltgExpr()                                                            */


/******************************************************************************/
/*                                                                            */
/*  Function:  evalFltg                                                       */
/*                                                                            */
/*  Synopsis:  Get the value of the current lexeme as a floating point value. */
/*             Floating point input is alwasy considered decimal.             */
/*             The general format of a floating point number is:              */
/*                +-ddd.dddE+-dd  where each d is a decimal digit.            */
/*                                                                            */
/******************************************************************************/
FLTG_T *evalFltg()
{
  int      current_state;
  int      current_col;
  WORD16   exponent;
  FLTG_T  *fltg;
  WORD32   input_value;
  BOOL     negate;
  BOOL     negate_exponent;
  int      next_state;
  int      right_digits;

  /* This uses a lexical analyzer to parse the floating point format.         */
  static BYTE state_table[][10] =
  {
    /*  0   1   2   3   4   5   6  Oolumn index                               */
    /*  +   -   d   .   E  sp   p      State  Comment                         */
     {  2,  1,  3,  4, 10, 10, 10  },  /*  0  Initial state.                  */
     { 11, 11,  3,  4, 11, 11, 11  },  /*  1  -                               */
     { 11, 11,  3,  4, 11, 11, 11  },  /*  2  +                               */
     { 10, 10, 10,  4,  6, 10, 10  },  /*  3  # (+-ddd)                       */
     { 11, 11,  5, 11, 11, 10, 10  },  /*  4  . (+-ddd.)                      */
     { 11, 11, 11, 11,  6, 10, 11  },  /*  5  # (+-ddd.ddd)                   */
     {  8,  7,  9, 11, 11, 11, 11  },  /*  6  E (+-ddd.dddE)                  */
     { 11, 11,  9, 11, 11, 11, 11  },  /*  7  - (+-ddd.dddE-                  */
     { 11, 11,  9, 11, 11, 11, 11  },  /*  8  + (+-ddd.dddE+                  */
     { 11, 11, 11, 11, 11, 10, 11  }   /*  9  # (+-ddd.dddE+-dd               */
                                       /* 10  Completion state                */
                                       /* 11  Error state.                    */
  };

  delimiter = line[lexterm];
  fltg = &fltg_ac;
  fltg->exponent = 0;
  fltg->mantissa = 0;
  input_value = 0;
  negate = FALSE;
  negate_exponent = FALSE;
  next_state = 0;
  exponent = 0;
  right_digits = 0;
  current_state = 0;

  while( TRUE )
  {
    /* Classify character.  This is the column index.                         */
    switch( line[lexstart] )
    {
    case '+':
      current_col = 0;
      break;

    case '-':
      current_col = 1;
      break;

    case '.':
      current_col = 3;
      break;

    case 'E':  case 'e':
      current_col = 4;
      break;

    default:
      if( isdigit( line[lexstart] ))
      {
        current_col = 2;
      }
      else if( isdone( line[lexstart] ))
      {
        current_col = 5;
      }
      else
      {
        current_col = 6;
      }
      break;
    }

    next_state = state_table[current_state][current_col];

    switch( next_state )
    {
    case 1:                             /*  -                                 */
      negate = TRUE;
    case 2:                             /*  +                                 */
      delimiter = line[lexterm];        /* Move past the + or - character.    */
      nextLexBlank();
      break;

    case 3:                             /* Number  (+-ddd)                    */
      input_value = evalDubl( 0 );      /* Integer part of the number.        */
      nextLexeme();                     /* Move past previous lexeme.         */
      break;

    case 4:
      delimiter = line[lexterm];
      nextLexBlank();                   /* Move past the . character.         */
      break;

    case 5:                             /* .  (+-ddd.ddd)                     */
                                        /* Fractional part of the number.     */
      input_value = evalDubl( input_value );
      right_digits = lexterm - lexstart;/* Digit count to right of decimal.   */
      nextLexeme();                     /* Move past previous lexeme.         */
      break;

    case 6:                             /* E  (+-ddd.dddE)                    */
      delimiter = line[lexstart];       /* Move past the E.                   */
      cc = lexstart + 1;                /* fix cc in case there was no sign   */
      nextLexBlank();
      break;

    case 7:                             /* -  (+-ddd.dddE-)                   */
      negate_exponent = TRUE;
    case 8:                             /* +  (+-ddd.dddE+)                   */
      delimiter = line[lexterm];        /* Move past the + or - character.    */
      nextLexBlank();
      break;

    case 9:                             /* #  (+-ddd.dddE+-dd)                */
      exponent = (int)evalDubl( 0 );    /* Exponent of floating point number. */
      if( negate_exponent ) { exponent = - exponent; }
      nextLexeme();                     /* Move past previous lexeme.         */
      break;

    case 10:                            /* Floating number parsed, convert    */
                                        /* the number.                        */
      if (input_value == 0)
      {
        fltg->mantissa = 0;
        fltg->exponent = 0;
        return fltg;
      }

      /* Get the exponent for the number as input.                            */
      exponent -= right_digits;

      /* Remove trailing zeros and adjust the exponent accordingly.           */
      while(( input_value % 10 ) == 0 )
      {
        input_value /= 10;
        exponent++;
      }

      /* Convert the number to floating point.  The number is calculated with */
      /* a 27 bit mantissa to improve precision.  The extra 3 bits are        */
      /* discarded after the result has been calculated.                      */
      fltg->exponent = 26;
      fltg->mantissa = input_value << 3;
      normalizeFltg( fltg );


      while( exponent != 0 )
      {
        if( exponent < 0 )
        {
          /* Decimal point is to the left. */
          fltg->mantissa /= 10;
          normalizeFltg( fltg );
          exponent++;
        }
        else if( exponent > 0 )
        {
          /* Decimal point is to the right. */
          fltg->mantissa *= 10;
          normalizeFltg( fltg );
          exponent--;
        }
      }

      /* Discard the extra precsion used for calculating the number.          */
      fltg->mantissa >>= 3;
      fltg->exponent -= 3;
      if( negate )
      {
        fltg->mantissa = (- fltg->mantissa ) & 077777777L;
      }
      return( fltg );

    case 11:                            /* Error in format.                   */
      /* Not a properly constructued floating point number.                   */
      return( fltg );
    default:
      break;
    }
    /* Set state for next pass through the loop.                              */
    current_state = next_state;
  }
} /* evalFltg()                                                               */



/******************************************************************************/
/*                                                                            */
/*  Function:  normalizeFltg                                                  */
/*                                                                            */
/*  Synopsis:  Normalize a PDP-8 double precision floating point number.      */
/*                                                                            */
/******************************************************************************/
void normalizeFltg( FLTG_T *fltg )
{
  /* Normalize the floating point number.                                     */
  if( fltg->mantissa != 0 )
  {
    if(( fltg->mantissa & ~0x3FFFFFFL ) == 0 )
    {
      while(( fltg->mantissa & ~0x1FFFFFFL ) == 0 )

      {
        fltg->mantissa <<= 1;
        fltg->exponent--;
      }
    }
    else
    {
      while(( fltg->mantissa & ~0x3FFFFFFL ) != 0 )
      {
        fltg->mantissa >>= 1;
        fltg->exponent++;
      }
    }
  }
  else
  {
    fltg->exponent = 0;
  }
  return;
}


/******************************************************************************/
/*                                                                            */
/*  Function:  incrementClc                                                   */
/*                                                                            */
/*  Synopsis:  Set the next assembly location.  Test for collision with       */
/*             the literal tables.                                            */
/*                                                                            */
/******************************************************************************/
WORD16 incrementClc()
{
  testForLiteralCollision( clc );

  /* Incrementing the location counter is not to change field setting.        */
  clc = ( clc & 070000 ) + (( clc + 1 ) & 07777 );
  fieldlc = clc & 07777;
  return( clc );
} /* incrementClc()                                                           */


/******************************************************************************/
/*                                                                            */
/*  Function:  testForLiteralCollision                                        */
/*                                                                            */
/*  Synopsis:  Test the given location for collision with the literal tables. */
/*                                                                            */
/******************************************************************************/
BOOL testForLiteralCollision( WORD16 loc )
{
  WORD16  pagelc;
  BOOL    result = FALSE;
  WORD16  tmppage;
  int     tmpfield;

  tmpfield = GET_PAGE_INDEX(loc);
  tmppage = loc & 07600;
  pagelc  = loc & 00177;

  if ( pagelc > max_page_used[tmpfield] ) 
  {
     max_page_used[tmpfield] = pagelc;
  }
  if ( pagelc >= cp[tmpfield].loc )
  {
    if ( tmppage == 0 )
    {
      errorMessage( &pz_literal_overflow, -1 );
    }
    else
    {
      errorMessage( &literal_overflow, -1 );
    }
    result = TRUE;
  }

  return( result );
} /* testForLiteralCollision()                                                */


/******************************************************************************/
/*                                                                            */
/*  Function:  readLine                                                       */
/*                                                                            */
/*  Synopsis:  Get next line of input.  Print previous line if needed.        */
/*                                                                            */
/******************************************************************************/
void readLine()
{
  WORD16  ix;
  WORD16  iy;
  char   inpline[LINELEN];

  listLine();                   /* List previous line if needed.              */
  lineno++;                     /* Count lines read.                          */
  indirect_generated = FALSE;   /* Mark no indirect address generated.        */
  listed = FALSE;               /* Mark as not listed.                        */
  cc = 0;                       /* Initialize column counter.                 */
  lexstartprev = 0;
  int n;                        /* Number of characters read */
  size_t inplineLen = sizeof(inpline) - 1;
  char *inplinePtr = inpline;

  error_in_line = FALSE;
  if((n = getline( &inplinePtr, &inplineLen, infile )) <= 0 )
  {
    inpline[0] = '$';
    inpline[1] = '\n';
    inpline[2] = '\0';
    if (!dollar_not_required) {
       error_in_line = TRUE;
    }
    n = 2;
  }

  /* Remove any tabs from the input line by inserting the required number     */
  /* of spaces to simulate N character tab stops, where N defaults to 8 and   */
  /* is set by the command line option -t. (RK 20071029)                      */
  /* Ignore \r if there is one.  (DPI 20150501)                               */
  /* Ignore nulls if there is one (DJG 20240102                               */
  for( ix = 0, iy = 0; ix < n && iy < (LINELEN - 2); ix++ )
  {
    switch( inpline[ix] )
    {
    case '\t':
      do
      {
        line[iy] = ' ';
        iy++;
      }
      while(( iy % tabstops ) != 0 && iy < (LINELEN - 2));
      break;

    case '\r':        /* dont copy the carriage return */
       break;

    case 0:           /* dont copy null */
       break;

    default:
      line[iy] = inpline[ix];
      iy++;
      break;
    }
  }
  if (iy >= (LINELEN - 2)) {
  	line [iy] = '\n';
  	iy++;
  } 
  line[iy] = '\0';

  maxcc = iy;                   /* Save the current line length.              */
  /* Save the first line for possible use as the listing title.               */
  if( lineno == 1 )
  {
    strcpy( list_title, line );
  }
} /* readLine()                                                               */


/******************************************************************************/
/*                                                                            */
/*  Function:  listLine                                                       */
/*                                                                            */
/*  Synopsis:  Output a line to the listing file.                             */
/*                                                                            */
/******************************************************************************/
void listLine()
/* generate a line of listing if not already done!                            */
{
  if( listfile != NULL && listed == FALSE )
  {
    printLine( line, 0, 0, LINE );
  }
} /* listLine()                                                               */


/******************************************************************************/
/*                                                                            */
/*  Function:  printPageBreak                                                 */
/*                                                                            */
/*  Synopsis:  Output a Top of Form and listing header if new page necessary. */
/*                                                                            */
/******************************************************************************/
void printPageBreak()
{
  if( page_lineno >= LIST_LINES_PER_PAGE )
         /*  ( list_lineno % LIST_LINES_PER_PAGE ) == 0 ) */
  {
    if( !list_title_set )
    {
      /* strcpy( list_title, line ); */
      if( list_title[strlen(list_title) - 1] == '\n' )
      {
        list_title[strlen(list_title) - 1] = '\0';
      }
      if( strlen( list_title ) > TITLELEN )
      {
        list_title[TITLELEN] = '\0';
      }
      list_title_set = TRUE;
    }
    topOfForm( list_title, NULL );

  }
} /* printPageBreak()                                                         */
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
