armstrong0/PDP8e/RK8E/rk8e_basic_tb.v

`timescale 1 ns / 10 ps
// imports clock period from parameters.v 
`define pulse(arg) #1 ``arg <=1 ; #(3*clock_period) ``arg <= 0



module rk8e_basic_tb;


reg [0:11] din,op,pc,instruction,ac,mq,sr;
wire [0:11] opt,mdout;
reg clk;
reg reset;
reg halt;
reg cont;
reg sing_step;
reg trigger;
reg int_req;
reg int_ena;
reg int_inh;
reg write_en;
wire [0:11] disk_bus,ma;
wire [4:0] state;
wire int_in_prog;
reg EAE_loop,EAE_mode;
reg [0:2] DF,IF;
wire [0:2] EMA;
reg UF;
wire [0:11] addr;

wire [0:14] dmaAddr;
reg [0:11] mem2disk;
//wire [0:11] mem2disk;
wire [0:11] disk2mem;
wire to_disk;

reg db_read,db_write;
wire break_in_prog;

reg MOSI_enable;
wire sdMOSIe;
wire sdCS,sdMOSI,sdMISO,sdSCLK;

assign sdMOSIe = MOSI_enable & sdMOSI;

sdsim SDSIM(.clk (clk),
    .reset (reset),
    .clear (clear),
    .sdCS (sdCS),
    .sdMOSI (sdMOSIe),
    .sdSCLK (sdSCLK),
    .sdMISO (sdMISO)
);


state_machine SM1(.clk (clk),
          .reset (reset),
          .halt (halt),
          .cont (cont),
          .single_step (sing_step),
          .instruction (instruction),
          .trigger (trigger),
          .state (state),
          .EAE_mode (EAE_mode),
          .EAE_loop (EAE_loop),
          .UF (UF),
          .data_break (data_break),
          .to_disk (to_disk),
		  .break_in_prog (break_in_prog),
          .int_ena (int_ena),
          .int_req (int_req),
          .int_inh (int_inh),
          .int_in_prog (int_in_prog));


ma MA (.clk (clk),
    .reset (reset),
    .pc (pc),
    .ac (ac),
    .mq (mq),
    .sr (sr),
    .sw (sw),
    .state (state),
     .addr_loadd (addr_loadd),
	 .depd (depd),
	 .examd (examd),
    .int_in_prog (int_in_prog),
    .IF (IF),
	.DF (DF),
	.dmaAddr (dmaAddr),
//	.mem2disk (mem2disk),
	.disk2mem (disk2mem),
	.to_disk (to_disk),
    .addr (addr),
    .EMA (EMA),
    .isz_skip (isz_skip),
//    .instruction (instruction),
    .ma (ma),
    .mdout (mdout));

rk8e RK8 (  .clk (clk),
    .reset (reset),
    .clear (clear),
    .instruction (instruction),
    .state (state),
    .ac (ac),
	.UF (UF),
    .disk_bus (disk_bus),  //from the point of view of the CPU
    /* verilator lint_off SYMRSVDWORD */
    .interrupt (interrupt),
    /* verilator lint_on SYMRSVDWORD */

    .data_break (data_break),
    .to_disk (to_disk),
	.break_in_prog (break_in_prog),
	.dmaAddr (dmaAddr),
    .dmaDIN  (mem2disk),
    .dmaDOUT (disk2mem),
    .skip (skip),
	     // Interface to SD Hardware
    .sdMISO    (sdMISO),      //! SD Data In
    .sdMOSI    (sdMOSI),      //! SD Data Out
    .sdSCLK    (sdSCLK),      //! SD Clock
    .sdCS      (sdCS)        //! SD Chip Select

);

`include "../parameters.v"
`include "disk_instructions.v"

always begin  
        #(clock_period/2) clk <= 1;
        #(clock_period/2) clk <= 0;
end

  

 initial begin
 $dumpfile("sdb.vcd");
 $dumpvars(0,clk,reset,MA,RK8,SM1);
 #100  reset <= 1;
 MOSI_enable <= 1'b1; // set to zero to test initialization failure
 EAE_loop <= 0;
 EAE_mode <= 0;
 UF <= 0;
 sing_step <=  0;
 cont <= 0;
 pc <= 12'd0;
int_req <= 0;
int_ena <= 0;
int_inh <= 1;
trigger <= 0;
db_read <= 0;
db_write <= 0;

mem2disk <= 12'o2525;

#100 reset <= 0;
#60 `pulse(cont);
wait(state == F0);
instruction <= CAF;         // CAF
// the #500 before the wait is so we progress from state F0 to FW
// so they all don't collapse to 1 wait
#500 wait (state <= F0);
ac <= 12'b010_000_000_000;  // write protect drive 0
instruction <= DLDC;
#500 wait (state <= F0);
ac <= 12'b010_000_000_010;  // write protect drive 1
instruction <= DLDC;
#500 wait (state <= F0);
ac <= 12'b010_000_000_100;  // write protect drive 2
instruction <= DLDC;
#500 wait (state <= F0);
ac <= 12'b010_000_000_110;  // write protect drive 3
instruction <= DLDC;
#500 wait (state == F0);
ac <= 12'b100_100_000_000;
instruction <= DLDC;
#500 wait (state == F0);
// now try to write to the disk
ac <= 12'b100_000_000_000;
instruction <= DLDC;
// write lock error doesn't happen until a write is called for
#500 wait (state == F0);
ac <= 12'o0000;
instruction <= DLAG;
#500 wait (state == F0);
instruction <= CAF;
// now try an intrrupt
#500 wait (state == F0);
ac <= 12'b010_000_000_000;  // write protect drive 0
instruction <= DLDC;

#500 wait (state == F0);
// now try to write to the disk
ac <= 12'b100_100_000_000; // notice the 1 bit in the second octet
instruction <= DLDC;

#500 wait (state == F0);
ac <= 12'o0000;
instruction <= DLAG;

#500 wait (RK8.status[7] == 1'b1)
//#5000 $finish;
// write lock error
instruction <= CAF; // clear the error
#500 wait (state == F0);
// now try cylinder errors #cym= 203, zero based
// max is o312 which has a 1 in cmd_reg[11] and o4500 in dar
// the car contains the least 7 bits of the cylinder, the msb
// is bit 11 of the cmd register
// set bit 11 of the cmd to 0
instruction <= DLDC;
#500 wait (state == F0);
// set cmd_reg bit 11 to zero
ac <= 12'o0000;
instruction <= DLDC;
#500 wait (state == F0);
// set the dar to o4500
ac <= 12'o4500;
instruction <= DLAG;
#500 wait (state == F0);
// should be no error
// set bit 11 of cmd to 1 still no error
ac <= 12'o0001;
instruction <= DLDC;
#500 wait (state == F0);
ac <= 12'o4540;
instruction <= DLAG;
#500 wait (state == F0);

#500 wait (RK8.status[0] == 1'b0);
//#500 wait (RK8.sdstate == 3'b001); // ready

ac <= 12'o0000;
instruction <= DLDC;
#500 wait (state == F0);
// try a read
#500 wait (RK8.sdstate == 3'b001); // ready

instruction <= DLAG;
#500 wait (state == F0);
instruction <= 12'o7000;
#500 wait (RK8.dmaREQ == 1'b1);
#500 wait (RK8.dmaGNT == 1'b0);

$writememh("ram_contents",MA.ram.mem,0,255);
// at this point we have completed a read operation on disk
// now try a write
// note that the image file is not saved

#500 wait (RK8.sdstate == 3'b001); // ready

instruction <= DRST;

#500 wait (state == F0);
// now try to write to the disk
ac <= 12'b100_000_000_000;
instruction <= DLDC;
#500 wait (state == F0);
ac <= 12'o0000;
instruction <= DLAG;

#500 wait (state == F0);
instruction <= 12'o7000;
#500 wait (RK8.dmaREQ == 1'b1);
#500 wait (RK8.dmaGNT == 1'b0);
#500 wait (RK8.sdstate == 3'b001); // ready
#20000 $finish;



end
endmodule
