armstrong0/PDP8e/RK8E/sd_tb.sv

`timescale 1 ns / 10 ps

module sd_tb;
  import sd_types::*;
  import sdspi_types::*;

  reg clk, reset, clear;

  wire sdMISO, sdMOSI, sdSCLK, sdCS;
  wire         [0:11] dmaDOUT;  //! DMA Data Out of Disk
  wire         [0:14] dmaADDR;  //! DMA Address
  wire                dmaRD;  //! DMA Read
  wire                dmaWR;  //! DMA Write
  wire                dmaREQ;  //! DMA Request
  sdOP_t              sdOP;
  logic        [0:14] sdMEMaddr;  //! Memory Address
  sdDISKaddr_t        sdDISKaddr;  //! Disk Address
  logic               sdLEN;  //! Sector Length

  logic        [0:11] dmaDIN;  //! DMA Data Into Disk
  logic               dmaGNT;  //! DMA Grant
  sdSTAT_t            sdSTAT;


  `include "../FPGA_image/clock_frequency.v"
  `include "../timing.v"
  parameter slow_dev = $rtoi(clock_frequency / (slow_spi * 2));
  parameter fast_dev = $rtoi(clock_frequency / (fast_spi * 2));

  logic [9:0] SlowDiv, FastDiv;

  assign SlowDiv = slow_dev;
  assign FastDiv = fast_dev;

  localparam clock_period = 1e9 / clock_frequency;

  sd SD (
      .clk    (clk),
      .reset  (reset),    //! Clock/Reset
      .clear  (clear),    //! IOCLR 
      .SlowDiv(SlowDiv),
      .FastDiv(FastDiv),

      // PDP8 Interface
      .dmaDIN    (dmaDIN),      //! DMA Data Into Disk
      .dmaDOUT   (dmaDOUT),     //! DMA Data Out of Disk
      .dmaADDR   (dmaADDR),     //! DMA Address
      .dmaRD     (dmaRD),       //! DMA Read
      .dmaWR     (dmaWR),       //! DMA Write
      .dmaREQ    (dmaREQ),      //! DMA Request
      .dmaGNT    (dmaGNT),      //! DMA Grant
      // Interface to SD Hardware
      .sdMISO    (sdMISO),      //! SD Data In
      .sdMOSI    (sdMOSI),      //! SD Data Out
      .sdSCLK    (sdSCLK),      //! SD Clock
      .sdCS      (sdCS),        //! SD Chip Select
      // RK8E Interface
      .sdOP      (sdOP),        //! SD OP
      .sdMEMaddr (sdMEMaddr),   //! Memory Address
      .sdDISKaddr(sdDISKaddr),  //! Disk Address
      .sdLEN     (sdLEN),       //! Sector Length
      .sdSTAT    (sdSTAT)       //! Status

  );

  sdsim SDM (
      .clk(clk),
      .reset(reset),
      .clear(clear),
      .sdMISO(sdMISO),
      .sdMOSI(sdMOSI),
      .sdSCLK(sdSCLK),
      .sdCS(sdCS)
  );

  sdSTATE_t sdstate;

  always @(posedge clk) begin
    sdstate <= sdSTAT.state;
  end
  always begin
    #(clock_period / 2) clk <= 1;
    #(clock_period / 2) clk <= 0;
  end

  initial begin
    $dumpfile("sdsim.vcd");
    $dumpvars(0, SD);

    clk <= 1'b0;
    #50 reset <= 1'b1;
    sdOP <= sdopNOP;
    #50 reset <= 1'b0;
    sdDISKaddr <= 32'd0;
    sdMEMaddr <= 15'd0;
    sdLEN <= 1'b0;
    dmaGNT <= 1'b0;
    dmaDIN <= 12'o5252;

    #1000000 sdOP <= sdopRD;  // read
    wait (dmaREQ == 1'b1);
    #20 dmaGNT <= 1'b1;
    sdOP <= sdopNOP;  // only read one sector
 
    wait (dmaREQ == 1'b0);
    #20 dmaGNT <= 1'b0;
    sdLEN <= 1'b1;  // set up to read 1/2 of a sector
    sdOP  <= sdopRD;
    wait (dmaREQ == 1'b1);
    #20 dmaGNT <= 1'b1;
    sdOP <= sdopNOP;  // only read one sector

    wait (dmaREQ == 1'b0);
    #20 dmaGNT <= 1'b0;
    wait (sdstate == 3'b001);
    //#10000 $finish ;

    #160 sdOP <= sdopWR;  // write
    wait (dmaREQ == 1'b1);
    #20 dmaGNT <= 1'b1;
    sdOP <= sdopNOP;  // only write 1/2 of one sector

    wait (dmaREQ == 1'b0);
    sdLEN <= 1'b0;  // set up to read full sector
    // but wait for sdstate to go idle
    wait (sdstate == 3'b001);

    sdOP <= sdopWR;  // write
    wait (dmaREQ == 1'b1);
    #20 dmaGNT <= 1'b1;
    sdOP <= sdopNOP;  // only read one sector
    wait (dmaREQ == 1'b0);
    #20 dmaGNT <= 1'b0;
    sdLEN <= 1'b0;  // set up to read full sector
    sdOP <= sdopWR;  // write
    wait (dmaREQ == 1'b0);

    #20 dmaGNT <= 1'b0;
    #25000 $finish;

  end

endmodule
