armstrong0/PDP8e/serial/tx.v

module tx (
    input clk100,
    input reset,
    input clear,
    input [15:0] baud_count,
    input [0:11] char,
    input load,
    input clear_flag,
    input set_flag,
    output reg flag,
    output reg tx
);
  `include "../parameters.v"
 
  /* verilator lint_off LITENDIAN */
  reg [15:0] period_cntr;
  reg [3:0] state;
  reg [0:7] tto;
  reg loaded;

  parameter IDLE =4'd0, START = 4'd1,
    BIT0 = 4'd2, BIT1 = 4'd3, BIT2 = 4'd4, BIT3 = 4'd5,
    BIT4 = 4'd6, BIT5 = 4'd7, BIT6 = 4'd8, BIT7 = 4'd9,
    STOP1 = 4'd10, STOP2 = 4'd11;

  always @(posedge clk100) begin
    if (reset | clear) begin
      flag <= 0;
      tto <= 8'o040;
      loaded <= 0;
      period_cntr <= 'd16;
      state <= IDLE;
      tx <= 1;
    end else begin
      if (clear_flag == 1) flag <= 0;
      if (set_flag == 1) flag <= 1;
      // this needs to be async to the rest of the state machine
      // the transmitter can be loaded in any one of these states
      // one loaded don't allow further loading
      // STOP1 and STP2 need to complete then go to idle
      // if loaded is true IDLE immediately goes to START
      // flag goes low singifies the tx being busy
      if (((state == IDLE) || (state == STOP1) || (state == STOP2))
                     && (load == 1)&& (loaded == 0)) // book says to use
                    // SPF 6040 to set the flag to start the output BUT
                    // the diagnostics
                    // don't do that.  Removed the flag requirement in the
                    // above
                    // allow loads in stop1 and stop2
            begin
        tto <= char[4:11];
        flag <= 0;
        loaded <= 1;
      end

      period_cntr <= period_cntr - 'd1;
      // actions happen at the end of the state!
      if (period_cntr == 0)
        case (state)
          IDLE: begin
            if (loaded == 1) //&& (flag == 1))
                        begin
              state <= START;
              period_cntr <= baud_count;
              flag <= 0;
            end else begin
              state <= IDLE;
              period_cntr <= 1;
            end
          end
          START: begin
            loaded <= 0;
            period_cntr <= baud_count;
            state <= BIT0;
          end

          // this depends on the states being in sequence
          // each state follows the previous at intervals of 1 baud
          BIT0, BIT1, BIT2, BIT3, BIT4, BIT5, BIT6, BIT7: begin
            period_cntr <= baud_count;
            state <= state + 4'b0001;
            if (state == BIT7) flag <= 1;
          end
          STOP1: begin
`ifdef ONESTOP
            state <= IDLE;
            period_cntr <= 1;
`else
            state <= STOP2;
            period_cntr <= baud_count;
`endif

          end
          STOP2: begin  // we are done set up for the next
            state <= IDLE;  // loaded might be set but idle will
            // sort it out very quickly
            period_cntr <= 1;
          end

          default: begin
            period_cntr <= 1;
            state <= IDLE;
          end

        endcase
      case (state)
        IDLE: tx <= 1;
        START: tx <= 0;  // send start bit
        BIT0: tx <= tto[7];
        BIT1: tx <= tto[6];
        BIT2: tx <= tto[5];
        BIT3: tx <= tto[4];
        BIT4: tx <= tto[3];
        BIT5: tx <= tto[2];
        BIT6: tx <= tto[1];
        BIT7: tx <= tto[0];
        STOP1: tx <= 1;
        STOP2: tx <= 1;
        default: tx <= 1;
      endcase

    end
  end
endmodule
