armstrong0/PDP8e/parameters.v

`define RK8E
//`define EAE
//`define up5k
//
//Auto Start
`define AS
// define one of
// RK8E - OS8 boot code
//`define AS_RK8E
// boot code for Doug Ingrams' Console Serial Device
`define AS_CSD

// state machine encoding
localparam F0 = 5'd0,  // 0
FW = 5'd1,  // 1
F1 = 5'd2,  // 2
F2 = 5'd3,  // 3
F2A = 5'd4,  // 4
F2B = 5'd5,  // 5
F3 = 5'd6,  // 6

D0 = 5'd7,  // 7
DW = 5'd8,  // 8
D1 = 5'd9,  // 9 
D2 = 5'd10,  // 10
D3 = 5'd11,  // 11

E0 = 5'd12,  // 12
EW = 5'd13,  // 13
E1 = 5'd14,  // 14
E2 = 5'd15,  // 15
E3 = 5'd16,  // 16

HW = 5'd17,  // 17
H1 = 5'd18,  // 18
H2 = 5'd19,  // 19
H3 = 5'd20;  // 20

`ifdef EAE
localparam EAE0 = 5'd21,  // 21
EAE1 = 5'd22,  // 22
EAE2 = 5'd23,  // 23
EAE3 = 5'd24,  // 24
EAE4 = 5'd29,  // 29
EAE5 = 5'd29,  // 30
EAE6 = 5'd29;  // 31

`endif

`ifdef RK8E
localparam DB0 = 5'd25,  // 25
DB1 = 5'd26,  // 26
DB2 = 5'd27,  // 27
DB3 = 5'd28;  // 28
`endif

// instruction encodings
`ifdef EAE


localparam SAM=12'o7457,
DAD  = 12'o7443,
DST  = 12'o7445, 
DPIC = 12'o7773,
DCM  = 12'o7575,
DPSZ = 12'o7451,
DLD  = 12'o7763,
CAMDAD = 12'o7663, 
SHL = 12'o7413,
ASR = 12'o7415,
LSR = 12'o7417,
MUL = 12'o7405,
DIV = 12'o7407,
NMI = 12'o7411;
`endif

`ifdef RK8E
localparam CAF = 12'o6007,  // clear all flags
DSKP = 12'o6741,  // skip if error or done
DCLC = 12'o6742,  // DCLC disk clear
DLAG = 12'o6743,  // DLAG load and go
DCLA = 12'o6744,  // DLCA load current address
DRST = 12'o6745,  // DRST read status
DLDC = 12'o6746;  // DLDC load command register
`endif

localparam  AND = 3'b000, 
TAD = 3'b001,
ISZ = 3'b010,
DCA = 3'b011,
JMS = 3'b100,
JMP = 3'b101,
OPR = 3'b111,
IOT = 3'b110,
JMPD =4'b1010,
JMPI = 4'b1011,
JM = 2'b10 ;

parameter real clock_frequency = 73500000;
parameter real clock_period = 1/clock_frequency*1e9;

// define the startup delay allowed for the sd card
// units of milliseconds

//`ifdef SIM
//parameter sd_delay = 2;
//`else
//parameter sd_delay = 10'd500;
//`endif

// two diagnostic tests will not pass with partial fields so change to 8k
// 2 fields when running those tests ADDER MEM_EXT

//parameter MAX_ADDRESS = 15'o23777; // 10k 2.5 fields
parameter MAX_ADDRESS = 15'o17777;  // 8k 2 fields
//parameter MAX_ADDRESS = 15'o77777; // 32k 8 fields
