armstrong0/PDP8e/RK8E/spi_tb.sv

`timescale 1 ns / 10 ps

module spi_tb;

  import sd_types::*;
  import sdspi_types::*;


  logic clk;
  logic rst;
  spiOP_t spiOP;
  sdBYTE_t spiTXD;
  wire sdBYTE_t spiRXD;
  reg spiMISO;

  wire spiSCLK;
  wire spiMOSI;
  wire spiCS;
  wire spiDONE;
  logic spiMIS0;
  `include "../FPGA_image/clock_frequency.v"
  `include "../timing.v"

  parameter slow_dev = $rtoi(clock_frequency / (slow_spi * 2));
  parameter fast_dev = $rtoi(clock_frequency / (fast_spi * 2));

  wire [9:0] SlowDiv, FastDiv;
  assign SlowDiv = slow_dev;
  assign FastDiv = fast_dev;

  sdspi UUT (
      .clk(clk),
      .rst(rst),
      .SlowDiv(SlowDiv),
      .FastDiv(FastDiv),
      .spiOP(spiOP),
      .spiTXD(spiTXD),
      .spiRXD(spiRXD),
      .spiCS(spiCS),
      .spiDONE(spiDONE),
      .spiMOSI(spiMOSI),
      .spiMISO(spiMISO),
      .spiSCLK(spiSCLK)
  );

  always begin
    #6.5 clk <= ~clk;
  end

  initial begin

    $dumpfile("sdspi_test.vcd");
    $dumpvars(0, UUT);


    spiMISO <= 1'b0;
    clk <= 1'b0;
    rst <= 1'b1;
    spiOP <= spiNOP;
    #50 spiOP <= spiCSL;
    #50 rst <= 1'b0;
    #50 spiOP <= spiSLOW;
    spiTXD <= 8'h55;
    #15 spiOP <= spiCSH;
    #15 spiOP <= spiTR;
    #15 spiOP <= spiNOP;
    wait (spiDONE == 1'b1) #10 spiOP <= spiFAST;
    #15 spiOP <= spiCSL;
    #15 spiOP <= spiCSH;
    #10 spiTXD <= 8'haa;
    #10 spiOP <= spiTR;
    wait (spiDONE == 1'b1) #300 $finish;


  end
endmodule
