armstrong0/PDP8e/ram/ram_tb.v

`timescale 1 ns / 10 ps
`define CLK #5 clk <= 1;  #5 clk <= 0;
module ram_tb;

wire [0:11] dout;
reg clk;
reg reset;
reg we;
reg [0:14] addr;
reg [0:11] din;



   ram UUT(.clk (clk),
       .din (din),
      .write_en (we),
      .addr (addr),
      .dout (dout));

initial begin
  $dumpfile("ram_results.vcd");
  $dumpvars(0);
  reset <=1;
  addr <= 15'o00000;
  clk   <= 0;
  we <= 0;
`CLK
din <= 12'o7777;
we <=1;
`CLK
addr <= 15'o10000;
din <= 12'o5252;
we <=1;
`CLK
addr <= 15'o17777;
din <= 12'o2525;
we <= 1;
`CLK 
we <=0;

addr <= 15'o00000;
`CLK 
addr <= 15'o10000;
`CLK
addr <= 15'o17777;
`CLK
din <= dout + 12'o0001;
we <= 1;
`CLK 
we <= 0;
`CLK 
// try an unimplemented address
addr <= 15'o20000;
din <= 12'o5252;

`CLK
we <= 1'b1;
`CLK
we <= 1'b0;
`CLK 
`CLK 
`CLK
`CLK
`CLK 
`CLK 
`CLK
`CLK
`CLK
`CLK
`CLK
`CLK
`CLK
`CLK
`CLK
`CLK
`CLK
`CLK
`CLK

end

endmodule
