armstrong0/PDP8e/(commit log)

2022-06-30 added the bin and rim loader to the image loaded into ram on power up
2022-08-30 Added lint using verilator, corrected a problem with halted cpu not being able to continue
    [D_mux.v, PDP8e.v, PDP8e_tb.v, ac.v, front_panel.v, front_panel_st_tb.v, front_panel_tb.v, imux.v]
2022-09-09 missed a commit on ma.v making corrections on ac.v
    [ac.v, ma.v]
2022-09-15 dd makefile modified test bed and some pdp8e assembler sources to assist with debugging EAE
2022-10-18 Cleaned up verilator flagged errors
    [ac.v, ma.v]
2022-12-18 A mode passes ASR/LSR combined in the iterate stage
2022-12-19 Found a bug in SCL and fixed it
    [ac.v, ma.v]
2022-12-22 Prep for major re-write of state_machine moving skips from ac to here
    [state_machine.v]
2023-02-12 first cut at data break functionality
2023-02-17 modified front panel to eliminate missed front panel key presses
    [ac.v, front_panel.v]
2023-03-14 sd simulation shows signs of life, now to debug the sim sd and spi moduleas
2023-03-16 more working, clkstat in sdsim was wrong
    [sdsim.sv]
2023-04-07 added timescale and slow and fast spi clocks
2023-04-11 fixed one bug in write, 1/2 length writes still not working
    [sd_tb.sv, sdsim.sv]
2023-04-14 first cut at a testbed
2023-04-16 no verilator systax errors
    [rk8e.sv, sd.sv, sdspi.sv]
2023-05-12 RK8e buffers read from sd, states appear correct
    [parameters.v, rk8e.sv, rk8e_basic_tb.v, state_machine.v]
2023-05-21 start of a full test bed for sdcard disk
2023-06-13 Cleaned up rk8e.sv, tested error conditions, cleaned up testbeds
    [rk8e.sv, rk8e_basic_tb.v, sd_tb.sv]
2023-06-18 first cut at a scanned front panel interface to cut pin count down
2023-06-19 LED matrix set, switcch matrix in process
2023-06-22 Added support for ICE40up5k device
2023-06-22 Fixed ifdef for EAE and RK8E
    [PDP8e.v, ac.v, ma.v]
2023-06-24 Rearranged EAE states in state_machine.v to help a human understand when EAE_skip is activated, in prep to fixing the pc in EAE0
    [PDP8e.pcf, pll.v, state_machine.v]
2023-07-04 bug in read full
    [rk8e.sv]
2023-07-14 fixed bug in state D0 to DW, modified main tb test adding extra wait state on upon autoincrement
    [state_machine.v, state_machine_tb.v]
2023-08-03 clean up bit rot, made front_panel big endian to avoid verilator complaints
    [PDP8e.v, front_panel.v, pll.v]
2023-08-22 reformated, changed tx so it no longer accepts charactors in STOP1 or STOP2
    [rx.v, serial_tb.v, tx.v, tx_tb.v]
2023-09-13 Fixed state being shortened to 1 bit
    [PDP8e.v]
2023-09-24 switches are working again
2023-10-11 serial test files moved to IO test, better more current testing
2023-12-09 changed module name form ac to Ac. changed format of numberic literals link renamed from l to link, removed il
2023-12-09 reset skip flag in F0
    [oper2.v]
2023-12-09 changed case to casez, used more casez (instead of if) defer states refined
2024-01-10 some clean up, RK8e now reads the first sector and copies it correctly to the proper locations
    [D_mux.v, PDP8e_tb.v, imux.v, ma.v, parameters.v, rk8e.sv, sdspi.sv, state_machine.v]
2024-02-12 Correct spi frequecy, off by a factor of 10
    [parameters.v]
2024-03-26 closer to a working simulation again, problems were with spi rates
    [PDP8e_tb.v, front_panel.v, parameters.v, sd.sv, sd_tb.sv, sdsim.sv, sdspi.sv]
2024-04-29 added delay to releasing reset of sdcard
    [rk8e.sv]
2024-05-16 reformated files in FPGA_IO_test added a new test bed in RK8e
2024-06-07 fixed unitialized registers, moved memreq one state earlier on writes
    [RW_tb.v, ma.v, sd.sv]
2024-06-29 corrected loading of the car from dma only when we come back from a read or write
    [rk8e.sv]
2024-07-06 RK8E support added in imux
2024-07-11 slowed down the slow spi clock
2024-07-22 RK8E still not working BUT it is repeatable, miss-behaving the same way each time
    [PDP8e.v, PDP8e_tb.v, ma.v, parameters.v, rk8e.sv, sd.sv]
2024-08-17 first cut at replacing rotary switch with a push button for display select
2024-08-25 Negated the dsel_sw button
2024-08-28 restored D_mux.v to pre-branch condition, changes are now entirely in front_panl.v PDP8e.v and the pcf file, not working quite right yet
    [D_mux.v, PDP8e.pcf, PDP8e.v, front_panel.v, front_panel_tb.v]
2024-08-30 working from panel with push button switch for display selection
2024-09-01 Modified PDP8e_tb.v to use the display select push button
2024-09-04 restored file eleted in error
    [dumprk05.c]
2024-09-13 corrected hex2oct to recognize the 0xff before every sector
    [PDP8e_tb.v, hex2oct.c]
2024-10-15 consolidated data_break conditionals, still does not work properly
    [PDP8e.pcf, PDP8e_tb.v, ma.v, ma_jms_st_tb.v, ma_tb.v, parameters.v, state_machine.v, state_machine_tb.v]
2024-12-20 files for a make which exhibits an extnpr problem I Think
    [PDP8e.pcf, PDP8e.v, PDP8e_tb.v]
2025-01-03 removed H0, H1 almost all of breaks in normal flow are handled in FW, RK8E can be ifdef'd out
2025-01-07 changed pulse widths to 3 clock cycles instead of four, front_panel stil produces four which may be a problem
    [state_machine_tb.v]
2025-01-07 ifdefs for EAE and RK8E, major changes in instruction flow happen in F0 instead of FW
2025-01-12 Fixed test bench so it actually runs, move if (UF== 0) outside of casez statements
    [mem_ext.v, mem_ext_tb.v]
2025-02-20 fixed bug with loading extended adress, added checkerboard, got rx_tb running again
    [PDP8e.v, imux.v, ma.v, mem_ext.v, parameters.v, rx.v, rx_tb.v]
2025-02-23 raised baud rate to 115200, using the correct clock frequency in simulation
    [parameters.v]
2025-02-23 rx_tb prints out values for alternate implementation of rx
2025-03-03 corrected data break operations
    [D_mux.v, PDP8e.v, PDP8e_tb.v, ma.v, state_machine.v]
2025-05-01 fixed some front panel stuff
    [front_panel_st_tb.v, front_panel_tb.v]
2025-05-29 added clear to reset variables, before it would come out of reset and the disk_rdy led would be on but once you pressed clear it would no
    [sd.sv]
2025-06-29 corrected palbart rk8e instructions, now dumping in octal, initial fast EAE shifts
    [ac.v, palbart.c, parameters.v, rk8e.sv]
2025-07-18 found a bug in simh which I patched with instrucions add to nmi.pa
    [PDP8e_EAE_tb.v, state_machine.v]
2025-08-04 added failing case
2025-08-11 run verilator in ac, sd and fixed errors
    [PDP8e.v, ac.v, parameters.v, sd.sv]
2025-10-14 remove timer from sd.sv, added additional state to data break, corrected address saving in ma.v
    [PDP8e.pcf, PDP8e.v, PDP8e_tb.v, ma.v, parameters.v, rk8e.sv, sd.sv, sdspi.sv]
2025-12-02 first stage in segragrating EAE
2026-02-22 corrected sd card writes
    [PDP8e_tb.v, sd.sv]
2026-05-16 re-write, found bug in erial_top that might have cause exraneous charactores to be transmitted
    [rx.v, rx_tb.v, serial_tb.v, serial_top.v, tx.v, tx_tb.v]
2026-05-16 add clock frequency so spi rates can be determined, will remove one FPGA specific clocks are in place
2026-05-16 fixed bug where rx required two stop bits to work properly
    [rx.v]
2026-06-09 fixed multiple driven cntr
    [front_panel.v]
2026-06-27 sd card reset seems to work, front panel support added
    [HX_clock.v, HX_clock_tb.v, PDP8e.v, PDP8e_tb.v, parameters.v, rk8e.sv, timing.v]
2026-07-01 corrected to run with newest version of iverilog
    [state_machine_tb.v]
2026-07-16 corrected rx.v - shift 8 bits
    [HX_clock.v, rx.v, rx_tb.v, timing.v]
2026-07-20 test of RK8e spi speed constants from HX_clocks
